joelsa/Jumperless/Hardware/JumperlessRev3.pdf

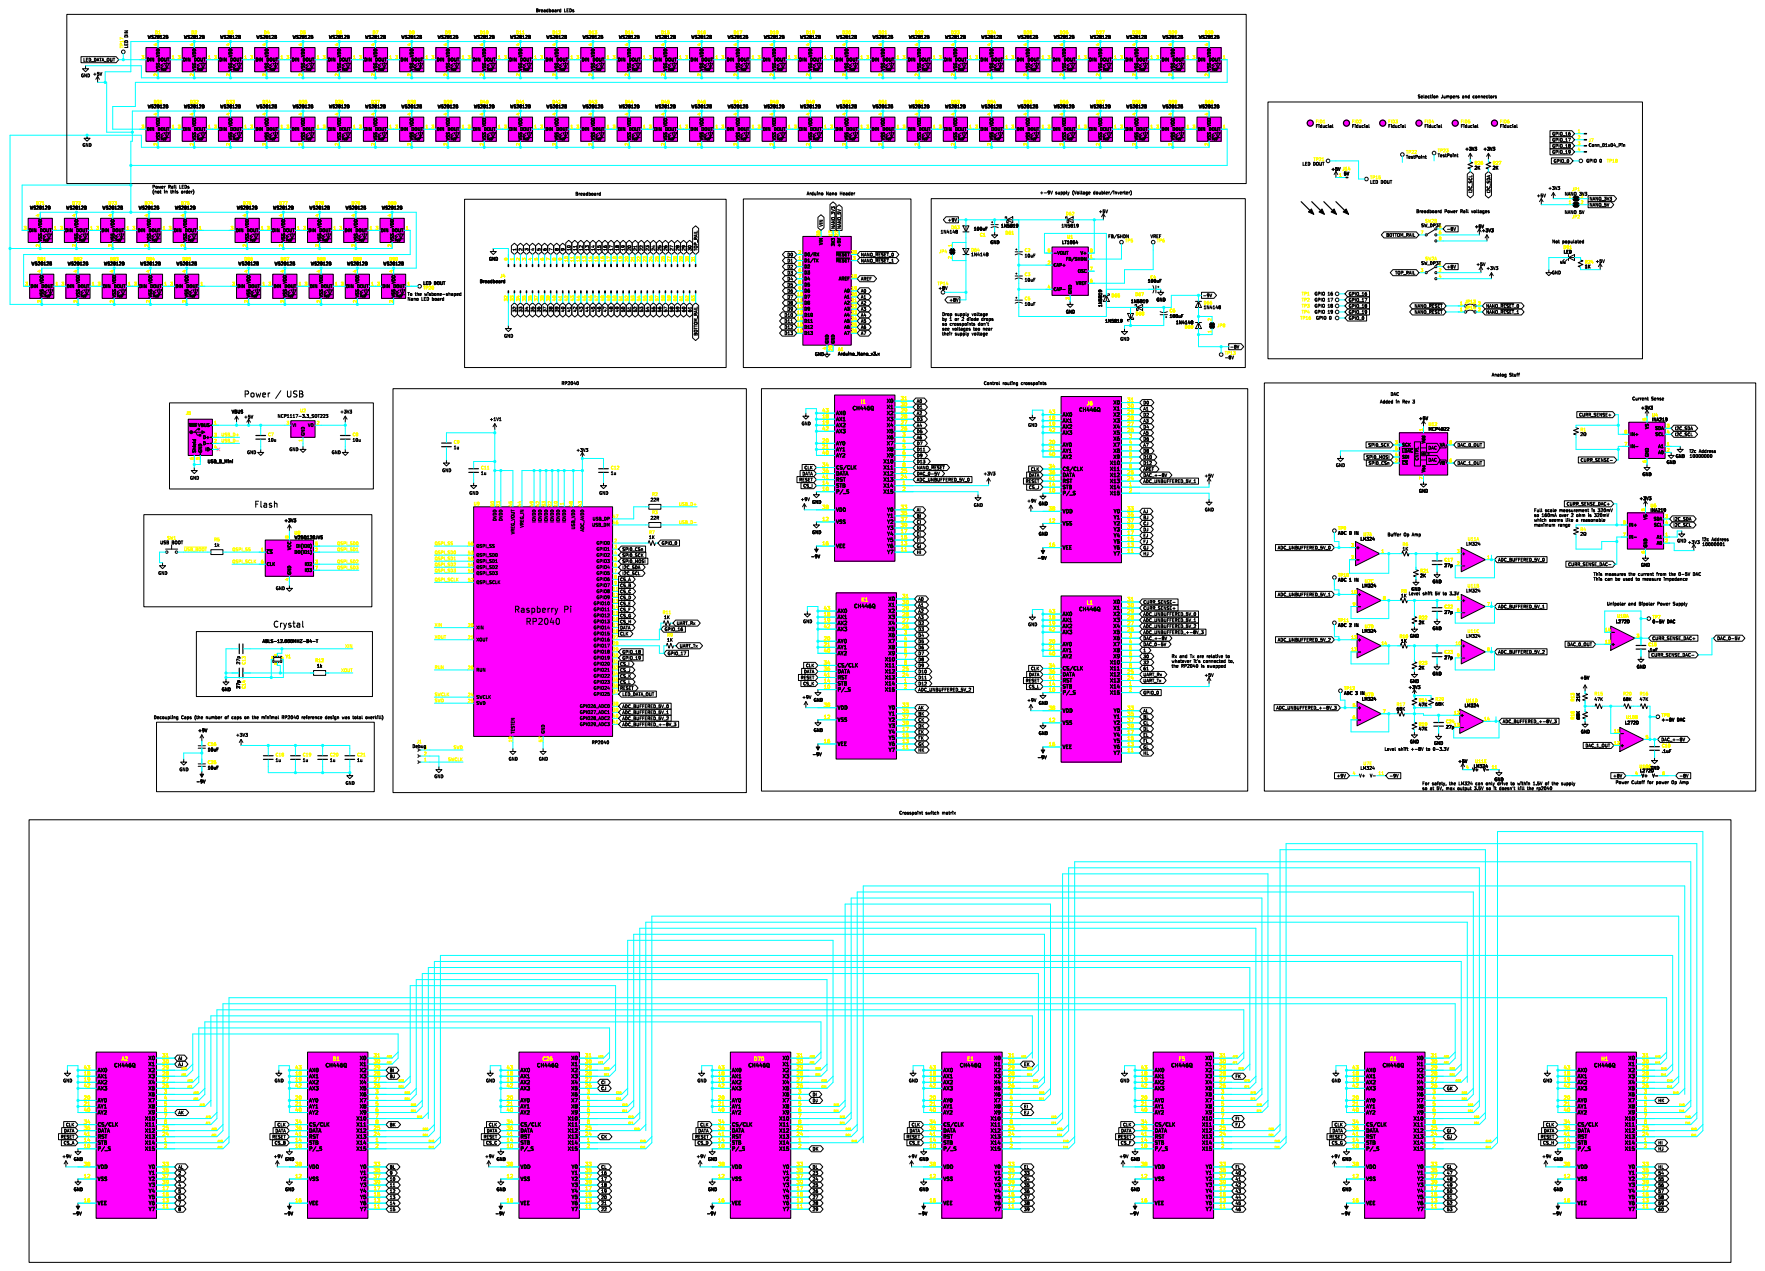
[picture p1: page 1]

To the wisbone-shaped Nano LED board Power Rail LEDs

2 DOUT 1 VBUS D86 WS2812B DIN 3 VDD

Current Sense Drop supply voltage
by 1 or 2 diode drops

their supply voltageControl routing crosspoints

Added in Rev 3 DAC

ADC_UNBUFFERED_5V_1 A7D12 D8 D10 AREF D11 D9 D13 D7A6NANO_~{RESET} HI GI FI AI DI CI BI EI A2D5A4D1 D3

DJ FJHJ GJ EJ BJ CJ AJ

This can be used to measure impedance

For safety, the LM324 can only drive to within 1.5V of the supply
