joelsa/Jumperless/Hardware/KiCAD/Jumperless Rev 3/JumperlessRev3.kicad_sch

## KiCad design Hardware/KiCAD/Jumperless Rev 3/JumperlessRev3.kicad_sch (2026-06-02)

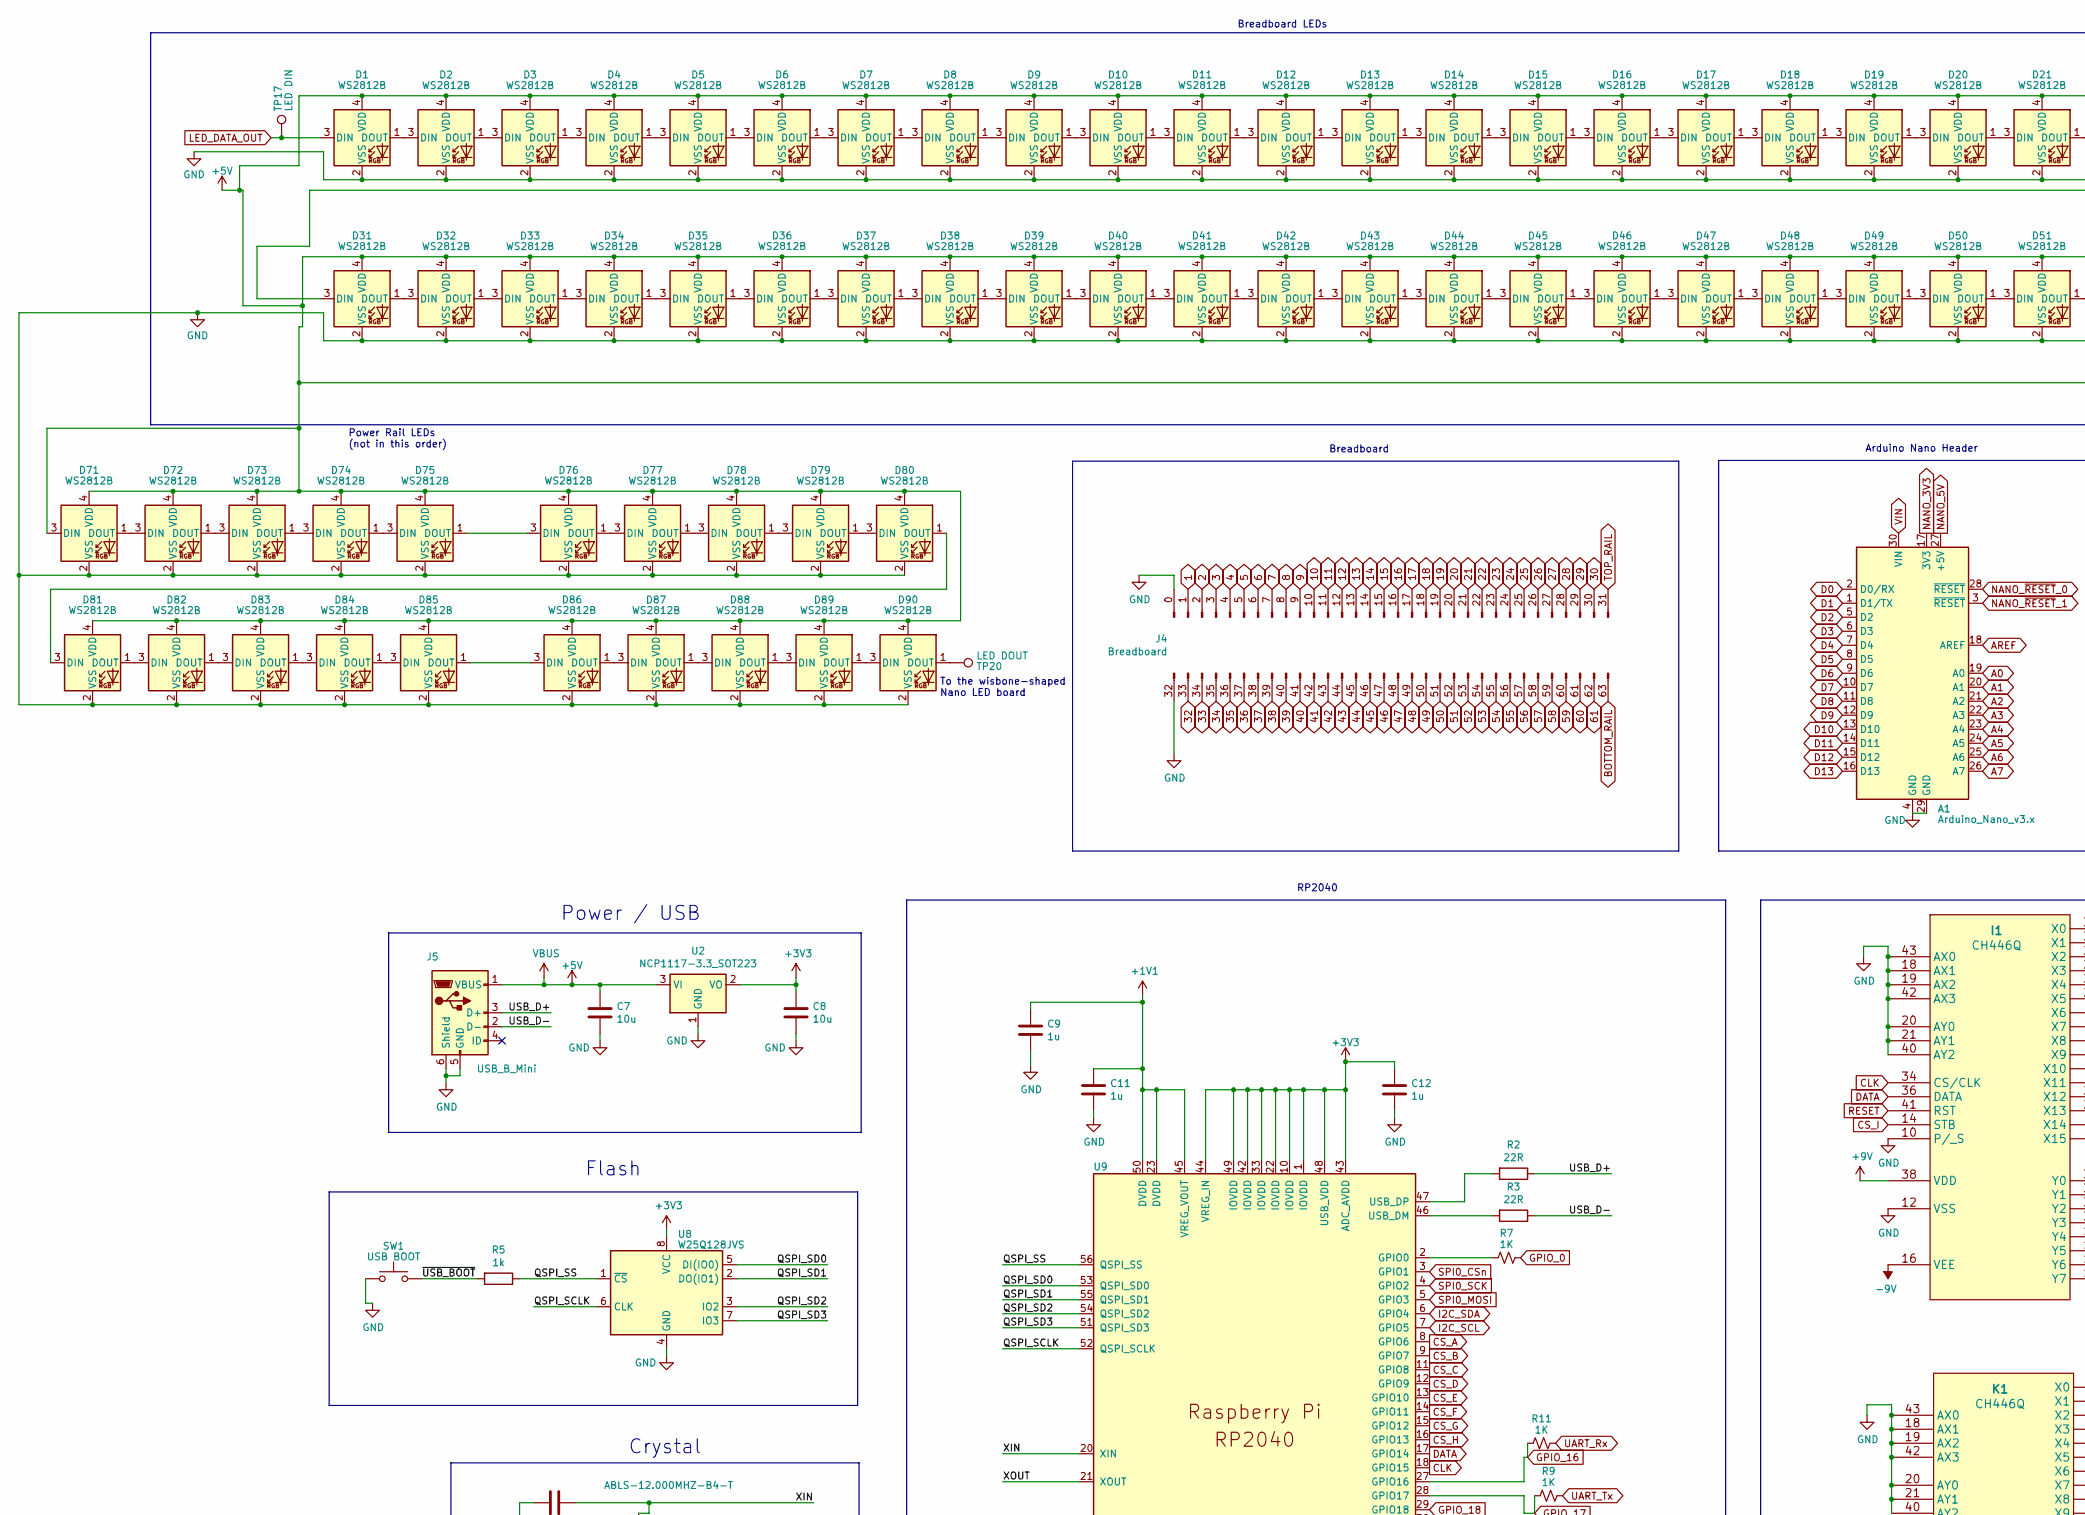
[picture p2: schematic JumperlessRev3.kicad_sch, part in row 1, column 1]

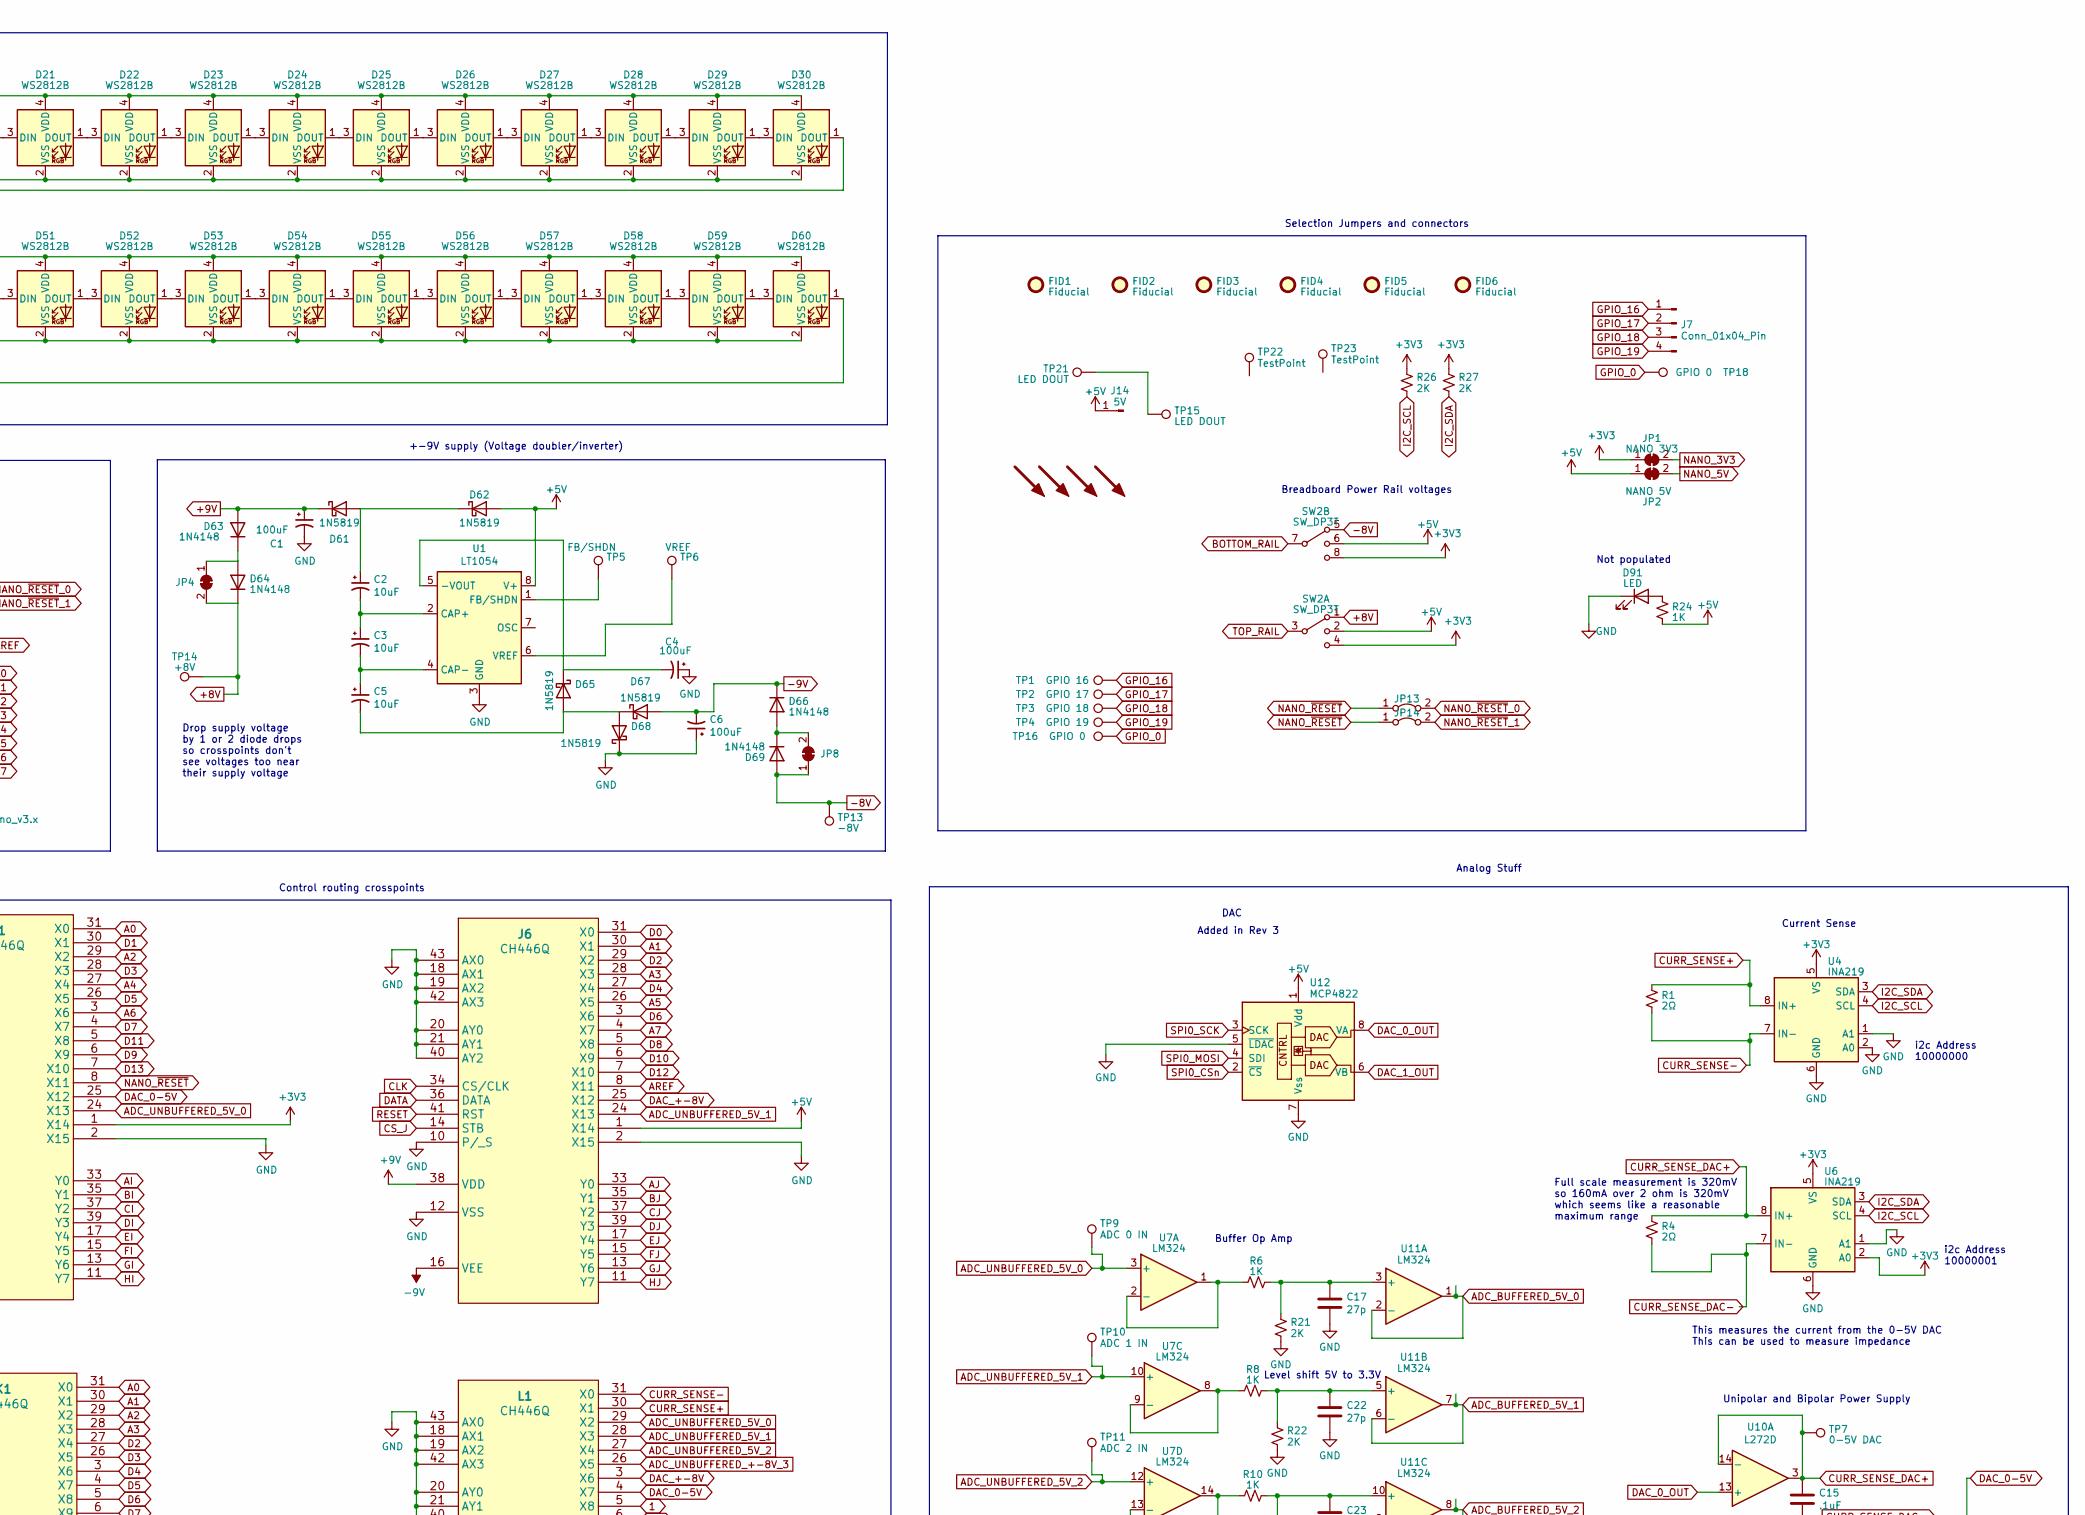
[picture p3: schematic JumperlessRev3.kicad_sch, part in row 1, column 2]

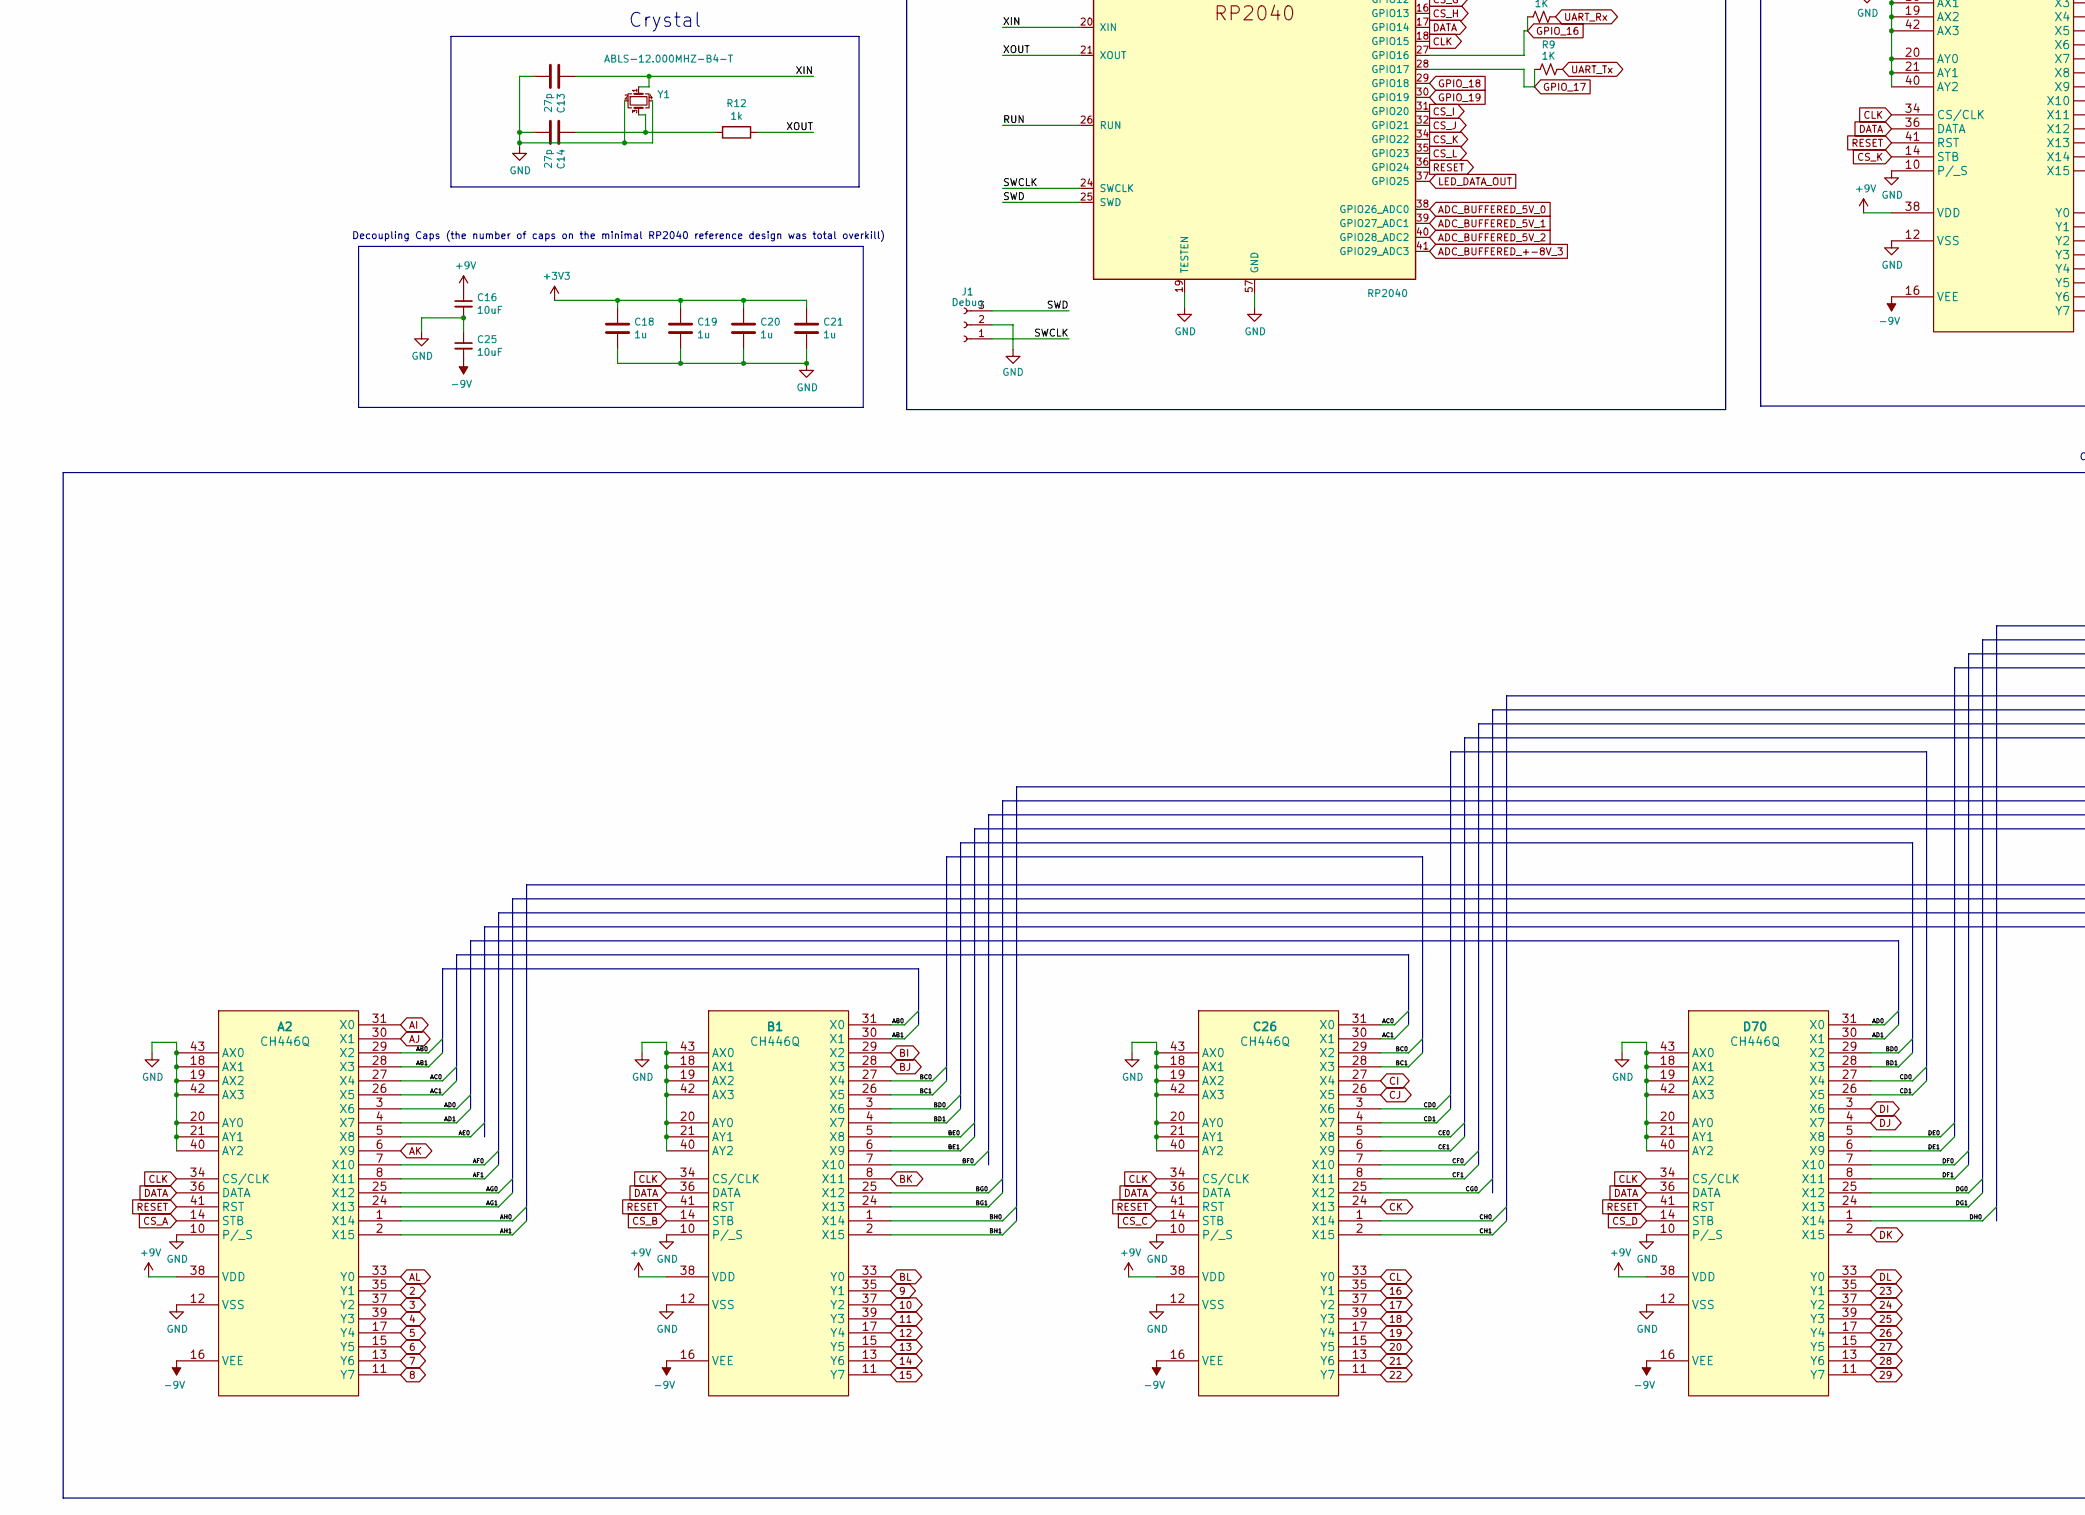
[picture p4: schematic JumperlessRev3.kicad_sch, part in row 2, column 1]

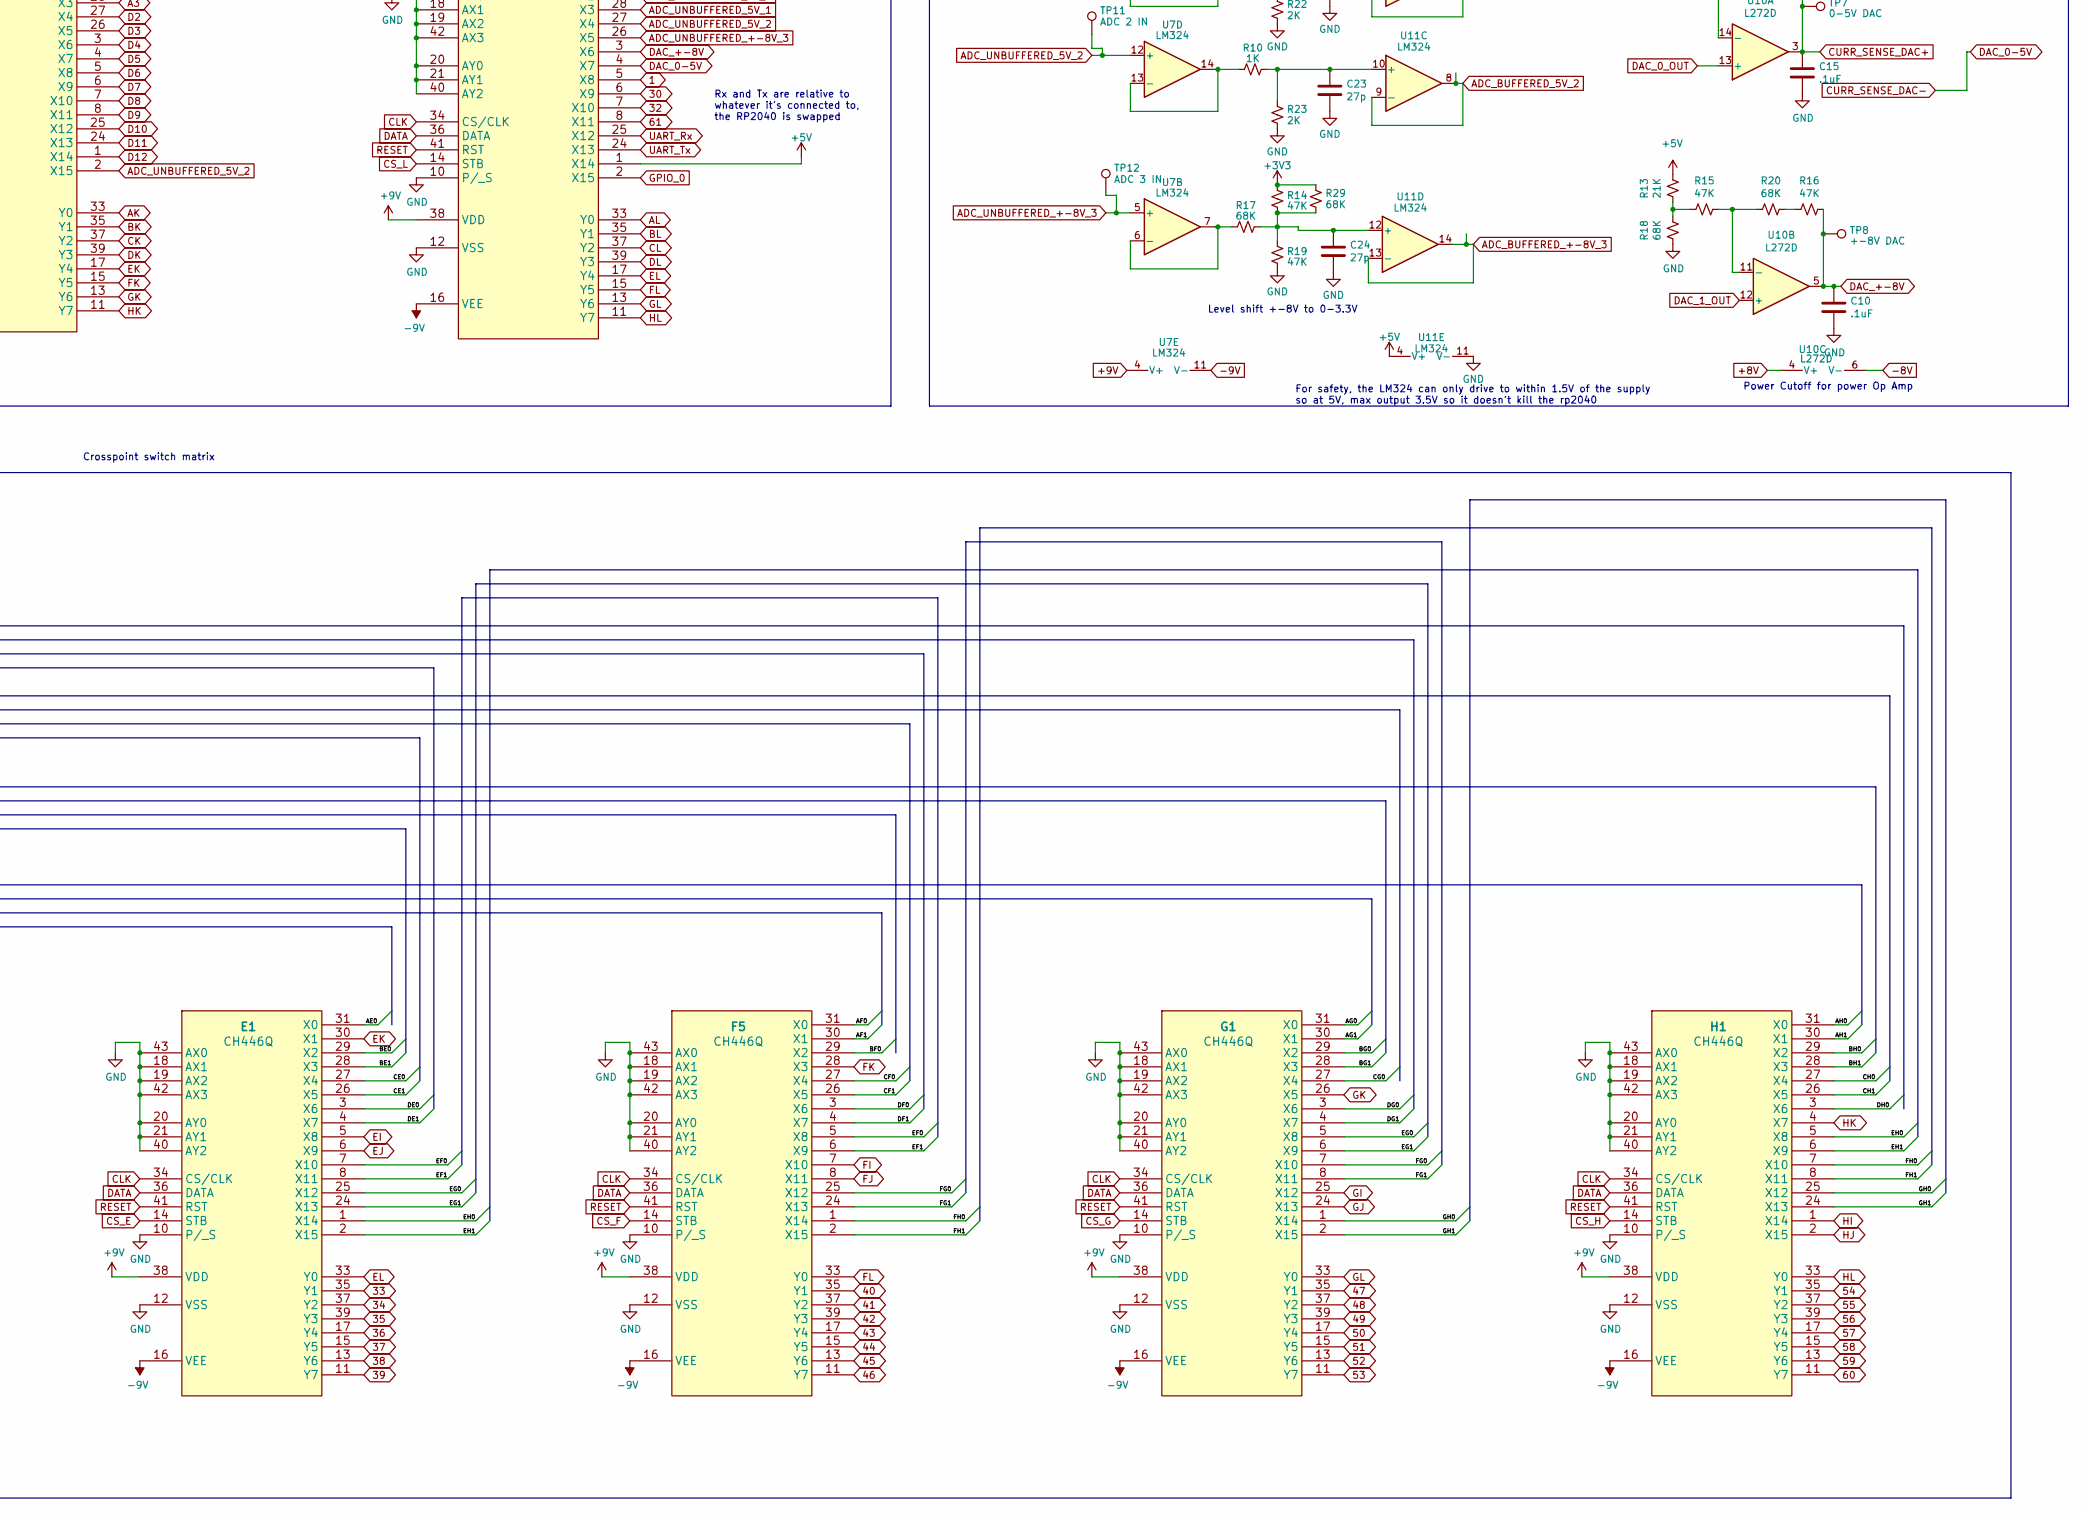
[picture p5: schematic JumperlessRev3.kicad_sch, part in row 2, column 2]

Parts:
A1: Arduino_Nano_v3.x; Arduino_Nano
A2: CH446Q; LQFP44_Tight
B1: CH446Q; LQFP44_Tight
C1, C4, C6: 100uF; C_1206_3216Metric_Pad1.33x1.80mm_HandSolder
C2, C3, C5: 10uF; CP_EIA-6032-20_AVX-F_Pad2.25x2.35mm_HandSolder
C7, C8: 10u; C_0603_1608Metric
C9, C11, C12, C18, C19, C20, C21: 1u; C_0402_1005Metric
C10, C15: .1uF; C_0402_1005Metric
C13, C14, C17, C22, C23, C24: 27p; C_0402_1005Metric
C16, C25: 10uF; C_0603_1608Metric
C26: CH446Q; LQFP44_Tight
D1, D2, D3, D4, D5, D6, D7, D8, D9, D10, D11, D12, D13, D14, D15, D16, D17, D18, D19, D20, D21, D22, D23, D24, D25, D26, D27, D28, D29, D30, D31, D32, D33, D34, D35, D36, D37, D38, D39, D40, D41, D42, D43, D44, D45, D46, D47, D48, D49, D50, D51, D52, D53, D54, D55, D56, D57, D58, D59, D60, D71, D72, D73, D74, D75, D76, D77, D78, D79, D80, D81, D82, D83, D84, D85, D86, D87, D88, D89, D90: WS2812B; LED_WS2812B-2020_PLCC4_2.0x2.0mm
D61, D62, D65, D67, D68: 1N5819; D_SOD-323
D63, D64, D66, D69: 1N4148; D_SOD-323
D70: CH446Q; LQFP44_Tight
D91: LED; LED_PLCC2_reversemount
E1: CH446Q; LQFP44_Tight
F5: CH446Q; LQFP44_Tight
FID1, FID2, FID3, FID4, FID5, FID6: Fiducial; Fiducial_1mm_Mask2mm
G1: CH446Q; LQFP44_Tight
H1: CH446Q; LQFP44_Tight
I1: CH446Q; LQFP44_Tight
J1: Debug; PinHeader_1x03_P2.54mm_Vertical
J4: Breadboard; Breadboard_CustomClips_Fallback
J5: USB_B_Mini; USB_Mini-B_Wuerth_65100516121_Horizontal
J6: CH446Q; LQFP44_Tight
J7: Conn_01x04_Pin; GPIO_header
J14: 5V; PINHEADER-1x1_vertical
JP1: NANO 3V3; SolderJumper_2_Bridged_Small
JP2: NANO 5V; SolderJumper_2_Bridged_Small
JP4, JP8: SolderJumper_2_Bridged; SolderJumper_2_Bridged_Small
JP13, JP14: Jumper_2_Bridged; SolderJumper_2_Bridged_Small
K1: CH446Q; LQFP44_Tight
L1: CH446Q; LQFP44_Tight
R1, R4: 2Ω; R_0603_1608Metric
R2, R3: 22R; R_0402_1005Metric
R5, R12: 1k; R_0402_1005Metric
R6, R7, R8, R9, R10, R11, R24: 1K; R_0402_1005Metric
R13: 21K; R_0402_1005Metric
R14, R15, R16, R19: 47K; R_0402_1005Metric
R17, R18, R20, R29: 68K; R_0402_1005Metric
R21, R22, R23, R26, R27: 2K; R_0402_1005Metric
SW1: USB BOOT; SW_SPST_TL3342
SW2: SW_DP3T; Slide_Switch_SSSS223600
TP1: GPIO 16; TestPoint_Pad_D1.0mm
TP2: GPIO 17; TestPoint_Pad_D1.0mm
TP3: GPIO 18; TestPoint_Pad_D1.0mm
TP4: GPIO 19; TestPoint_Pad_D1.0mm
TP5: FB/SHDN; TestPoint_D0.75mm
TP6: VREF; TestPoint_D0.75mm
TP7: 0-5V DAC; TestPoint_D0.75mm
TP8: +-8V DAC; TestPoint_D0.75mm
TP9: ADC 0 IN; TestPoint_D0.75mm
TP10: ADC 1 IN; TestPoint_D0.75mm
TP11: ADC 2 IN; TestPoint_D0.75mm
TP12: ADC 3 IN; TestPoint_D0.75mm
TP13: -8V; TestPoint_D0.75mm
TP14: +8V; TestPoint_D0.75mm
TP15: LED DOUT; TestPoint_Pad_D1.0mm
TP16: GPIO 0; TestPoint_Pad_D1.0mm
TP17: LED DIN; TestPoint_Pad_D1.0mm
TP18: GPIO 0; PINHEADER-1x1_vertical
TP20, TP21: LED DOUT; PINHEADER-1x1_vertical
TP22, TP23: TestPoint; BackMaskWindows
U1: LT1054; DIP-8_W7.62mm
U2: NCP1117-3.3_SOT223; SOT-223-3_TabPin2
U4, U6: INA219; SOIC-8_3.9x4.9mm_P1.27mm
U7, U11: LM324; SOIC-14_3.9x8.7mm_P1.27mm
U8: W25Q128JVS; SOIC-8_5.23x5.23mm_P1.27mm
U9: RP2040; RP2040-QFN-56
U10: L272D; SOIC-16_3.9x9.9mm_P1.27mm
U12: MCP4822; SOIC-8_3.9x4.9mm_P1.27mm
Y1: ABLS-12.000MHZ-B4-T; Crystal_SMD_3225-4Pin_3.2x2.5mm

Connections:
1: J4.1, L1.5 (X8)
2: A2.35 (Y1), J4.2
3: A2.37 (Y2), J4.3
4: A2.39 (Y3), J4.4
5: A2.17 (Y4), J4.5
6: A2.15 (Y5), J4.6
7: A2.13 (Y6), J4.7
8: A2.11 (Y7), J4.8
9: B1.35 (Y1), J4.9
10: B1.37 (Y2), J4.10
11: B1.39 (Y3), J4.11
12: B1.17 (Y4), J4.12
13: B1.15 (Y5), J4.13
14: B1.13 (Y6), J4.14
15: B1.11 (Y7), J4.15
16: C26.35 (Y1), J4.16
17: C26.37 (Y2), J4.17
18: C26.39 (Y3), J4.18
19: C26.17 (Y4), J4.19
20: C26.15 (Y5), J4.20
21: C26.13 (Y6), J4.21
22: C26.11 (Y7), J4.22
23: D70.35 (Y1), J4.23
24: D70.37 (Y2), J4.24
25: D70.39 (Y3), J4.25
26: D70.17 (Y4), J4.26
27: D70.15 (Y5), J4.27
28: D70.13 (Y6), J4.28
29: D70.11 (Y7), J4.29
30: J4.30, L1.6 (X9)
32: J4.33 (Pin_1), L1.7 (X10)
33: E1.35 (Y1), J4.34 (Pin_2)
34: E1.37 (Y2), J4.35 (Pin_3)
35: E1.39 (Y3), J4.36 (Pin_4)
36: E1.17 (Y4), J4.37 (Pin_5)
37: E1.15 (Y5), J4.38 (Pin_6)
38: E1.13 (Y6), J4.39 (Pin_7)
39: E1.11 (Y7), J4.40 (Pin_8)
40: F5.35 (Y1), J4.41 (Pin_9)
41: F5.37 (Y2), J4.42 (Pin_10)
42: F5.39 (Y3), J4.43 (Pin_11)
43: F5.17 (Y4), J4.44 (Pin_12)
44: F5.15 (Y5), J4.45 (Pin_13)
45: F5.13 (Y6), J4.46 (Pin_14)
46: F5.11 (Y7), J4.47 (Pin_15)
47: G1.35 (Y1), J4.48 (Pin_16)
48: G1.37 (Y2), J4.49 (Pin_17)
49: G1.39 (Y3), J4.50 (Pin_18)
50: G1.17 (Y4), J4.51 (Pin_19)
51: G1.15 (Y5), J4.52 (Pin_20)
52: G1.13 (Y6), J4.53 (Pin_21)
53: G1.11 (Y7), J4.54 (Pin_22)
54: H1.35 (Y1), J4.55 (Pin_23)
55: H1.37 (Y2), J4.56 (Pin_24)
56: H1.39 (Y3), J4.57 (Pin_25)
57: H1.17 (Y4), J4.58 (Pin_26)
58: H1.15 (Y5), J4.59 (Pin_27)
59: H1.13 (Y6), J4.60 (Pin_28)
60: H1.11 (Y7), J4.61 (Pin_29)
61: J4.62 (Pin_30), L1.8 (X11)
+1V1: C9.1, C11.1, U9.23 (DVDD), U9.45 (VREG_VOUT), U9.50 (DVDD)
+3V3: C8.1, C12.1, C18.1, C19.1, C20.1, C21.1, I1.1 (X14), JP1.1 (A), R14.1, R26.1, R27.1, R29.1, SW2.4, SW2.8, U2.2 (VO), U4.5 (VS), U6.2 (A0), U6.5 (VS), U8.8 (VCC), U9.1 (IOVDD), U9.10 (IOVDD), U9.22 (IOVDD), U9.33 (IOVDD), U9.42 (IOVDD), U9.43 (ADC_AVDD), U9.44 (VREG_IN), U9.48 (USB_VDD), U9.49 (IOVDD)
+5V: C7.1, D1.4 (VDD), D2.4 (VDD), D3.4 (VDD), D4.4 (VDD), D5.4 (VDD), D6.4 (VDD), D7.4 (VDD), D8.4 (VDD), D9.4 (VDD), D10.4 (VDD), D11.4 (VDD), D12.4 (VDD), D13.4 (VDD), D14.4 (VDD), D15.4 (VDD), D16.4 (VDD), D17.4 (VDD), D18.4 (VDD), D19.4 (VDD), D20.4 (VDD), D21.4 (VDD), D22.4 (VDD), D23.4 (VDD), D24.4 (VDD), D25.4 (VDD), D26.4 (VDD), D27.4 (VDD), D28.4 (VDD), D29.4 (VDD), D30.4 (VDD), D31.4 (VDD), D32.4 (VDD), D33.4 (VDD), D34.4 (VDD), D35.4 (VDD), D36.4 (VDD), D37.4 (VDD), D38.4 (VDD), D39.4 (VDD), D40.4 (VDD), D41.4 (VDD), D42.4 (VDD), D43.4 (VDD), D44.4 (VDD), D45.4 (VDD), D46.4 (VDD), D47.4 (VDD), D48.4 (VDD), D49.4 (VDD), D50.4 (VDD), D51.4 (VDD), D52.4 (VDD), D53.4 (VDD), D54.4 (VDD), D55.4 (VDD), D56.4 (VDD), D57.4 (VDD), D58.4 (VDD), D59.4 (VDD), D60.1 (DOUT), D60.4 (VDD), D62.2 (A), D71.3 (DIN), D71.4 (VDD), D72.4 (VDD), D73.4 (VDD), D74.4 (VDD), D75.4 (VDD), D76.4 (VDD), D77.4 (VDD), D78.4 (VDD), D79.4 (VDD), D80.4 (VDD), D81.4 (VDD), D82.4 (VDD), D83.4 (VDD), D84.4 (VDD), D85.4 (VDD), D86.4 (VDD), D87.4 (VDD), D88.4 (VDD), D89.4 (VDD), D90.4 (VDD), J5.1 (VBUS), J6.1 (X14), J14.1, JP2.1 (A), L1.1 (X14), R13.2, R24.2, SW2.2, SW2.6, U1.8 (V+), U2.3 (VI), U11.4 (V+), U12.1 (Vdd)
+8V: D64.1 (K), JP4.2 (B), SW2.1, TP14.1, U10.4 (V+)
+9V: A2.38 (VDD), B1.38 (VDD), C1.1, C16.1, C26.38 (VDD), D61.1 (K), D63.2 (A), D70.38 (VDD), E1.38 (VDD), F5.38 (VDD), G1.38 (VDD), H1.38 (VDD), I1.38 (VDD), J6.38 (VDD), K1.38 (VDD), L1.38 (VDD), U7.4 (V+)
-8V: D69.2 (A), JP8.1 (A), SW2.5, TP13.1, U10.6 (V-)
-9V: A2.16 (VEE), B1.16 (VEE), C6.2, C25.2, C26.16 (VEE), D66.1 (K), D67.2 (A), D70.16 (VEE), E1.16 (VEE), F5.16 (VEE), G1.16 (VEE), H1.16 (VEE), I1.16 (VEE), J6.16 (VEE), K1.16 (VEE), L1.16 (VEE), U7.11 (V-)
A0: A1.19 (A0), I1.31 (X0), K1.31 (X0)
A1: A1.20 (A1), J6.30 (X1), K1.30 (X1)
A2: A1.21 (A2), I1.29 (X2), K1.29 (X2)
A3: A1.22 (A3), J6.28 (X3), K1.28 (X3)
A4: A1.23 (A4), I1.27 (X4)
A5: A1.24 (A5), J6.26 (X5)
A6: A1.25 (A6), I1.3 (X6)
A7: A1.26 (A7), J6.4 (X7)
AB0: A2.29 (X2), B1.31 (X0)
AB1: A2.28 (X3), B1.30 (X1)
AC0: A2.27 (X4), C26.31 (X0)
AC1: A2.26 (X5), C26.30 (X1)
AD0: A2.3 (X6), D70.31 (X0)
AD1: A2.4 (X7), D70.30 (X1)
ADC_BUFFERED_5V_0: U9.38 (GPIO26_ADC0), U11.1, U11.2 (-)
ADC_BUFFERED_5V_1: U9.39 (GPIO27_ADC1), U11.6 (-), U11.7
ADC_BUFFERED_5V_2: U9.40 (GPIO28_ADC2), U11.8, U11.9 (-)
ADC_BUFFERED_+-8V_3: U9.41 (GPIO29_ADC3), U11.13 (-), U11.14
ADC_UNBUFFERED_5V_0: I1.24 (X13), L1.29 (X2), TP9.1, U7.3 (+)
ADC_UNBUFFERED_5V_1: J6.24 (X13), L1.28 (X3), TP10.1, U7.10 (+)
ADC_UNBUFFERED_5V_2: K1.2 (X15), L1.27 (X4), TP11.1, U7.12 (+)
ADC_UNBUFFERED_+-8V_3: L1.26 (X5), TP12.1, U7.5 (+)
AE0: A2.5 (X8), E1.31 (X0)
AF0: A2.7 (X10), F5.31 (X0)
AF1: A2.8 (X11), F5.30 (X1)
AG0: A2.25 (X12), G1.31 (X0)
AG1: A2.24 (X13), G1.30 (X1)
AH0: A2.1 (X14), H1.31 (X0)
AH1: A2.2 (X15), H1.30 (X1)
AI: A2.31 (X0), I1.33 (Y0)
AJ: A2.30 (X1), J6.33 (Y0)
AK: A2.6 (X9), K1.33 (Y0)
AL: A2.33 (Y0), L1.33 (Y0)
AREF: A1.18 (AREF), J6.8 (X11)
BC0: B1.27 (X4), C26.29 (X2)
BC1: B1.26 (X5), C26.28 (X3)
BD0: B1.3 (X6), D70.29 (X2)
BD1: B1.4 (X7), D70.28 (X3)
BE0: B1.5 (X8), E1.29 (X2)
BE1: B1.6 (X9), E1.28 (X3)
BF0: B1.7 (X10), F5.29 (X2)
BG0: B1.25 (X12), G1.29 (X2)
BG1: B1.24 (X13), G1.28 (X3)
BH0: B1.1 (X14), H1.29 (X2)
BH1: B1.2 (X15), H1.28 (X3)
BI: B1.29 (X2), I1.35 (Y1)
BJ: B1.28 (X3), J6.35 (Y1)
BK: B1.8 (X11), K1.35 (Y1)
BL: B1.33 (Y0), L1.35 (Y1)
BOTTOM_RAIL: J4.63 (Pin_31), SW2.7
CD0: C26.3 (X6), D70.27 (X4)
CD1: C26.4 (X7), D70.26 (X5)
CE0: C26.5 (X8), E1.27 (X4)
CE1: C26.6 (X9), E1.26 (X5)
CF0: C26.7 (X10), F5.27 (X4)
CF1: C26.8 (X11), F5.26 (X5)
CG0: C26.25 (X12), G1.27 (X4)
CH0: C26.1 (X14), H1.27 (X4)
CH1: C26.2 (X15), H1.26 (X5)
CI: C26.27 (X4), I1.37 (Y2)
CJ: C26.26 (X5), J6.37 (Y2)
CK: C26.24 (X13), K1.37 (Y2)
CL: C26.33 (Y0), L1.37 (Y2)
CLK: A2.34 (CS/CLK), B1.34 (CS/CLK), C26.34 (CS/CLK), D70.34 (CS/CLK), E1.34 (CS/CLK), F5.34 (CS/CLK), G1.34 (CS/CLK), H1.34 (CS/CLK), I1.34 (CS/CLK), J6.34 (CS/CLK), K1.34 (CS/CLK), L1.34 (CS/CLK), U9.18 (GPIO15)
CS_A: A2.14 (STB), U9.8 (GPIO6)
CS_B: B1.14 (STB), U9.9 (GPIO7)
CS_C: C26.14 (STB), U9.11 (GPIO8)
CS_D: D70.14 (STB), U9.12 (GPIO9)
CS_E: E1.14 (STB), U9.13 (GPIO10)
CS_F: F5.14 (STB), U9.14 (GPIO11)
CS_G: G1.14 (STB), U9.15 (GPIO12)
CS_H: H1.14 (STB), U9.16 (GPIO13)
CS_I: I1.14 (STB), U9.31 (GPIO20)
CS_J: J6.14 (STB), U9.32 (GPIO21)
CS_K: K1.14 (STB), U9.34 (GPIO22)
CS_L: L1.14 (STB), U9.35 (GPIO23)
CURR_SENSE+: L1.30 (X1), R1.1, U4.8 (IN+)
CURR_SENSE-: L1.31 (X0), R1.2, U4.7 (IN-)
CURR_SENSE_DAC+: C15.1, R4.1, TP7.1, U6.8 (IN+), U10.3, U10.14 (-)
CURR_SENSE_DAC-: I1.25 (X12), L1.4 (X7), R4.2, U6.7 (IN-)
D0: A1.2 (D0/RX), J6.31 (X0)
D1: A1.1 (D1/TX), I1.30 (X1)
D2: A1.5 (D2), J6.29 (X2), K1.27 (X4)
D3: A1.6 (D3), I1.28 (X3), K1.26 (X5)
D4: A1.7 (D4), J6.27 (X4), K1.3 (X6)
D5: A1.8 (D5), I1.26 (X5), K1.4 (X7)
D6: A1.9 (D6), J6.3 (X6), K1.5 (X8)
D7: A1.10 (D7), I1.4 (X7), K1.6 (X9)
D8: A1.11 (D8), J6.5 (X8), K1.7 (X10)
D9: A1.12 (D9), I1.6 (X9), K1.8 (X11)
D10: A1.13 (D10), J6.6 (X9), K1.25 (X12)
D11: A1.14 (D11), I1.5 (X8), K1.24 (X13)
D12: A1.15 (D12), J6.7 (X10), K1.1 (X14)
D13: A1.16 (D13), I1.7 (X10)
DAC_0_OUT: U10.13 (+), U12.8 (VA)
DAC_1_OUT: U10.12 (+), U12.6 (VB)
DAC_+-8V: C10.1, J6.25 (X12), L1.3 (X6), R16.2, TP8.1, U10.5
DATA: A2.36 (DATA), B1.36 (DATA), C26.36 (DATA), D70.36 (DATA), E1.36 (DATA), F5.36 (DATA), G1.36 (DATA), H1.36 (DATA), I1.36 (DATA), J6.36 (DATA), K1.36 (DATA), L1.36 (DATA), U9.17 (GPIO14)
DE0: D70.5 (X8), E1.3 (X6)
DE1: D70.6 (X9), E1.4 (X7)
DF0: D70.7 (X10), F5.3 (X6)
DF1: D70.8 (X11), F5.4 (X7)
DG0: D70.25 (X12), G1.3 (X6)
DG1: D70.24 (X13), G1.4 (X7)
DH0: D70.1 (X14), H1.3 (X6)
DI: D70.3 (X6), I1.39 (Y3)
DJ: D70.4 (X7), J6.39 (Y3)
DK: D70.2 (X15), K1.39 (Y3)
DL: D70.33 (Y0), L1.39 (Y3)
EF0: E1.7 (X10), F5.5 (X8)
EF1: E1.8 (X11), F5.6 (X9)
EG0: E1.25 (X12), G1.5 (X8)
EG1: E1.24 (X13), G1.6 (X9)
EH0: E1.1 (X14), H1.5 (X8)
EH1: E1.2 (X15), H1.6 (X9)
EI: E1.5 (X8), I1.17 (Y4)
EJ: E1.6 (X9), J6.17 (Y4)
EK: E1.30 (X1), K1.17 (Y4)
EL: E1.33 (Y0), L1.17 (Y4)
FG0: F5.25 (X12), G1.7 (X10)
FG1: F5.24 (X13), G1.8 (X11)
FH0: F5.1 (X14), H1.7 (X10)
FH1: F5.2 (X15), H1.8 (X11)
FI: F5.7 (X10), I1.15 (Y5)
FJ: F5.8 (X11), J6.15 (Y5)
FK: F5.28 (X3), K1.15 (Y5)
FL: F5.33 (Y0), L1.15 (Y5)
GH0: G1.1 (X14), H1.25 (X12)
GH1: G1.2 (X15), H1.24 (X13)
GI: G1.25 (X12), I1.13 (Y6)
GJ: G1.24 (X13), J6.13 (Y6)
GK: G1.26 (X5), K1.13 (Y6)
GL: G1.33 (Y0), L1.13 (Y6)
GND: A1.4 (GND), A1.29 (GND), A2.10 (P/_S), A2.12 (VSS), A2.18 (AX1), A2.19 (AX2), A2.20 (AY0), A2.21 (AY1), A2.40 (AY2), A2.42 (AX3), A2.43 (AX0), B1.10 (P/_S), B1.12 (VSS), B1.18 (AX1), B1.19 (AX2), B1.20 (AY0), B1.21 (AY1), B1.40 (AY2), B1.42 (AX3), B1.43 (AX0), C1.2, C4.1, C6.1, C7.2, C8.2, C9.2, C10.2, C11.2, C12.2, C13.2, C14.2, C15.2, C16.2, C17.2, C18.2, C19.2, C20.2, C21.2, C22.2, C23.2, C24.2, C25.1, C26.10 (P/_S), C26.12 (VSS), C26.18 (AX1), C26.19 (AX2), C26.20 (AY0), C26.21 (AY1), C26.40 (AY2), C26.42 (AX3), C26.43 (AX0), D1.2 (VSS), D2.2 (VSS), D3.2 (VSS), D4.2 (VSS), D5.2 (VSS), D6.2 (VSS), D7.2 (VSS), D8.2 (VSS), D9.2 (VSS), D10.2 (VSS), D11.2 (VSS), D12.2 (VSS), D13.2 (VSS), D14.2 (VSS), D15.2 (VSS), D16.2 (VSS), D17.2 (VSS), D18.2 (VSS), D19.2 (VSS), D20.2 (VSS), D21.2 (VSS), D22.2 (VSS), D23.2 (VSS), D24.2 (VSS), D25.2 (VSS), D26.2 (VSS), D27.2 (VSS), D28.2 (VSS), D29.2 (VSS), D30.2 (VSS), D31.2 (VSS), D32.2 (VSS), D33.2 (VSS), D34.2 (VSS), D35.2 (VSS), D36.2 (VSS), D37.2 (VSS), D38.2 (VSS), D39.2 (VSS), D40.2 (VSS), D41.2 (VSS), D42.2 (VSS), D43.2 (VSS), D44.2 (VSS), D45.2 (VSS), D46.2 (VSS), D47.2 (VSS), D48.2 (VSS), D49.2 (VSS), D50.2 (VSS), D51.2 (VSS), D52.2 (VSS), D53.2 (VSS), D54.2 (VSS), D55.2 (VSS), D56.2 (VSS), D57.2 (VSS), D58.2 (VSS), D59.2 (VSS), D60.2 (VSS), D68.1 (K), D70.10 (P/_S), D70.12 (VSS), D70.18 (AX1), D70.19 (AX2), D70.20 (AY0), D70.21 (AY1), D70.40 (AY2), D70.42 (AX3), D70.43 (AX0), D71.2 (VSS), D72.2 (VSS), D73.2 (VSS), D74.2 (VSS), D75.2 (VSS), D76.2 (VSS), D77.2 (VSS), D78.2 (VSS), D79.2 (VSS), D80.2 (VSS), D81.2 (VSS), D82.2 (VSS), D83.2 (VSS), D84.2 (VSS), D85.2 (VSS), D86.2 (VSS), D87.2 (VSS), D88.2 (VSS), D89.2 (VSS), D90.2 (VSS), D91.1 (K), E1.10 (P/_S), E1.12 (VSS), E1.18 (AX1), E1.19 (AX2), E1.20 (AY0), E1.21 (AY1), E1.40 (AY2), E1.42 (AX3), E1.43 (AX0), F5.10 (P/_S), F5.12 (VSS), F5.18 (AX1), F5.19 (AX2), F5.20 (AY0), F5.21 (AY1), F5.40 (AY2), F5.42 (AX3), F5.43 (AX0), G1.10 (P/_S), G1.12 (VSS), G1.18 (AX1), G1.19 (AX2), G1.20 (AY0), G1.21 (AY1), G1.40 (AY2), G1.42 (AX3), G1.43 (AX0), H1.10 (P/_S), H1.12 (VSS), H1.18 (AX1), H1.19 (AX2), H1.20 (AY0), H1.21 (AY1), H1.40 (AY2), H1.42 (AX3), H1.43 (AX0), I1.2 (X15), I1.10 (P/_S), I1.12 (VSS), I1.18 (AX1), I1.19 (AX2), I1.20 (AY0), I1.21 (AY1), I1.40 (AY2), I1.42 (AX3), I1.43 (AX0), J1.2, J4.0, J4.32 (Pin_0), J5.5 (GND), J5.6 (Shield), J6.2 (X15), J6.10 (P/_S), J6.12 (VSS), J6.18 (AX1), J6.19 (AX2), J6.20 (AY0), J6.21 (AY1), J6.40 (AY2), J6.42 (AX3), J6.43 (AX0), K1.10 (P/_S), K1.12 (VSS), K1.18 (AX1), K1.19 (AX2), K1.20 (AY0), K1.21 (AY1), K1.40 (AY2), K1.42 (AX3), K1.43 (AX0), L1.10 (P/_S), L1.12 (VSS), L1.18 (AX1), L1.19 (AX2), L1.20 (AY0), L1.21 (AY1), L1.40 (AY2), L1.42 (AX3), L1.43 (AX0), R18.1, R19.2, R21.2, R22.2, R23.2, SW1.1, U1.3 (GND), U2.1 (GND), U4.1 (A1), U4.2 (A0), U4.6 (GND), U6.1 (A1), U6.6 (GND), U8.4 (GND), U9.19 (TESTEN), U9.57 (GND), U11.11 (V-), U12.5 (~LDAC), U12.7 (Vss), Y1.2, Y1.4
GPIO_0: L1.2 (X15), R7.2, TP16.1, TP18.1
GPIO_16: J7.1, R11.1, TP1.1, U9.27 (GPIO16)
GPIO_17: J7.2, R9.1, TP2.1, U9.28 (GPIO17)
GPIO_18: J7.3, TP3.1, U9.29 (GPIO18)
GPIO_19: J7.4, TP4.1, U9.30 (GPIO19)
HI: H1.1 (X14), I1.11 (Y7)
HJ: H1.2 (X15), J6.11 (Y7)
HK: H1.4 (X7), K1.11 (Y7)
HL: H1.33 (Y0), L1.11 (Y7)
I2C_SCL: R26.2, U4.4 (SCL), U6.4 (SCL), U9.7 (GPIO5)
I2C_SDA: R27.2, U4.3 (SDA), U6.3 (SDA), U9.6 (GPIO4)
LED_DATA_OUT: D1.3 (DIN), TP17.1, U9.37 (GPIO25)
NANO_3V3: A1.17 (3V3), JP1.2 (B)
NANO_5V: A1.27 (+5V), JP2.2 (B)
NANO_~RESET: I1.8 (X11), JP13.1 (A), JP14.1 (A)
NANO_~RESET_0: A1.28 (~RESET), JP13.2 (B)
NANO_~RESET_1: A1.3 (~RESET), JP14.2 (B)
unnamed: C2.1, D61.2 (A), D62.1 (K)
unnamed: C2.2, C3.1, U1.2 (CAP+)
unnamed: C3.2, C5.1, U1.4 (CAP-)
unnamed: C4.2, D65.1 (K), U1.5 (-VOUT)
unnamed: C5.2, D65.2 (A), D67.1 (K), D68.2 (A)
unnamed: C14.1, R12.2, Y1.3
unnamed: C17.1, R6.2, R21.1, U11.3 (+)
unnamed: C22.1, R8.2, R22.1, U11.5 (+)
unnamed: C23.1, R10.2, R23.1, U11.10 (+)
unnamed: C24.1, R14.2, R17.2, R19.1, R29.2, U11.12 (+)
unnamed: D1.1 (DOUT), D2.3 (DIN)
unnamed: D2.1 (DOUT), D3.3 (DIN)
unnamed: D3.1 (DOUT), D4.3 (DIN)
unnamed: D4.1 (DOUT), D5.3 (DIN)
unnamed: D5.1 (DOUT), D6.3 (DIN)
unnamed: D6.1 (DOUT), D7.3 (DIN)
unnamed: D7.1 (DOUT), D8.3 (DIN)
unnamed: D8.1 (DOUT), D9.3 (DIN)
unnamed: D10.1 (DOUT), D11.3 (DIN)
unnamed: D9.1 (DOUT), D10.3 (DIN)
unnamed: D11.1 (DOUT), D12.3 (DIN)
unnamed: D12.1 (DOUT), D13.3 (DIN)
unnamed: D13.1 (DOUT), D14.3 (DIN)
unnamed: D14.1 (DOUT), D15.3 (DIN)
unnamed: D15.1 (DOUT), D16.3 (DIN)
unnamed: D16.1 (DOUT), D17.3 (DIN)
unnamed: D17.1 (DOUT), D18.3 (DIN)
unnamed: D18.1 (DOUT), D19.3 (DIN)
unnamed: D19.1 (DOUT), D20.3 (DIN)
unnamed: D20.1 (DOUT), D21.3 (DIN)
unnamed: D21.1 (DOUT), D22.3 (DIN)
unnamed: D22.1 (DOUT), D23.3 (DIN)
unnamed: D23.1 (DOUT), D24.3 (DIN)
unnamed: D24.1 (DOUT), D25.3 (DIN)
unnamed: D25.1 (DOUT), D26.3 (DIN)
unnamed: D26.1 (DOUT), D27.3 (DIN)
unnamed: D27.1 (DOUT), D28.3 (DIN)
unnamed: D28.1 (DOUT), D29.3 (DIN)
unnamed: D29.1 (DOUT), D30.3 (DIN)
unnamed: D30.1 (DOUT), D31.3 (DIN)
unnamed: D31.1 (DOUT), D32.3 (DIN)
unnamed: D32.1 (DOUT), D33.3 (DIN)
unnamed: D33.1 (DOUT), D34.3 (DIN)
unnamed: D34.1 (DOUT), D35.3 (DIN)
unnamed: D35.1 (DOUT), D36.3 (DIN)
unnamed: D36.1 (DOUT), D37.3 (DIN)
unnamed: D37.1 (DOUT), D38.3 (DIN)
unnamed: D38.1 (DOUT), D39.3 (DIN)
unnamed: D39.1 (DOUT), D40.3 (DIN)
unnamed: D40.1 (DOUT), D41.3 (DIN)
unnamed: D41.1 (DOUT), D42.3 (DIN)
unnamed: D42.1 (DOUT), D43.3 (DIN)
unnamed: D43.1 (DOUT), D44.3 (DIN)
unnamed: D44.1 (DOUT), D45.3 (DIN)
unnamed: D45.1 (DOUT), D46.3 (DIN)
unnamed: D46.1 (DOUT), D47.3 (DIN)
unnamed: D47.1 (DOUT), D48.3 (DIN)
unnamed: D48.1 (DOUT), D49.3 (DIN)
unnamed: D49.1 (DOUT), D50.3 (DIN)
unnamed: D50.1 (DOUT), D51.3 (DIN)
unnamed: D51.1 (DOUT), D52.3 (DIN)
unnamed: D52.1 (DOUT), D53.3 (DIN)
unnamed: D53.1 (DOUT), D54.3 (DIN)
unnamed: D54.1 (DOUT), D55.3 (DIN)
unnamed: D55.1 (DOUT), D56.3 (DIN)
unnamed: D56.1 (DOUT), D57.3 (DIN)
unnamed: D57.1 (DOUT), D58.3 (DIN)
unnamed: D58.1 (DOUT), D59.3 (DIN)
unnamed: D59.1 (DOUT), D60.3 (DIN)
unnamed: D63.1 (K), D64.2 (A), JP4.1 (A)
unnamed: D66.2 (A), D69.1 (K), JP8.2 (B)
unnamed: D71.1 (DOUT), D72.3 (DIN)
unnamed: D72.1 (DOUT), D73.3 (DIN)
unnamed: D73.1 (DOUT), D74.3 (DIN)
unnamed: D74.1 (DOUT), D75.3 (DIN)
unnamed: D75.1 (DOUT), D76.3 (DIN)
unnamed: D76.1 (DOUT), D77.3 (DIN)
unnamed: D77.1 (DOUT), D78.3 (DIN)
unnamed: D78.1 (DOUT), D79.3 (DIN)
unnamed: D79.1 (DOUT), D80.3 (DIN)
unnamed: D80.1 (DOUT), D81.3 (DIN)
unnamed: D81.1 (DOUT), D82.3 (DIN)
unnamed: D82.1 (DOUT), D83.3 (DIN)
unnamed: D83.1 (DOUT), D84.3 (DIN)
unnamed: D84.1 (DOUT), D85.3 (DIN)
unnamed: D85.1 (DOUT), D86.3 (DIN)
unnamed: D86.1 (DOUT), D87.3 (DIN)
unnamed: D87.1 (DOUT), D88.3 (DIN)
unnamed: D88.1 (DOUT), D89.3 (DIN)
unnamed: D89.1 (DOUT), D90.3 (DIN)
unnamed: D90.1 (DOUT), TP20.1
unnamed: D91.2 (A), R24.1
unnamed: R2.2, U9.47 (USB_DP)
unnamed: R3.2, U9.46 (USB_DM)
unnamed: R6.1, U7.1, U7.2 (-)
unnamed: R7.1, U9.2 (GPIO0)
unnamed: R8.1, U7.8, U7.9 (-)
unnamed: R10.1, U7.13 (-), U7.14
unnamed: R13.1, R15.1, R18.2
unnamed: R15.2, R20.1, U10.11 (-)
unnamed: R16.1, R20.2
unnamed: R17.1, U7.6 (-), U7.7
unnamed: TP5.1, U1.1 (FB/SHDN)
unnamed: TP6.1, U1.6 (VREF)
unnamed: TP15.1, TP21.1
QSPI_SCLK: U8.6 (CLK), U9.52 (QSPI_SCLK)
QSPI_SD0: U8.5 (DI(IO0)), U9.53 (QSPI_SD0)
QSPI_SD1: U8.2 (DO(IO1)), U9.55 (QSPI_SD1)
QSPI_SD2: U8.3 (IO2), U9.54 (QSPI_SD2)
QSPI_SD3: U8.7 (IO3), U9.51 (QSPI_SD3)
QSPI_SS: R5.1, U8.1 (~CS), U9.56 (QSPI_SS)
RESET: A2.41 (RST), B1.41 (RST), C26.41 (RST), D70.41 (RST), E1.41 (RST), F5.41 (RST), G1.41 (RST), H1.41 (RST), I1.41 (RST), J6.41 (RST), K1.41 (RST), L1.41 (RST), U9.36 (GPIO24)
RUN: U9.26 (RUN)
SPI0_CSn: U9.3 (GPIO1), U12.2 (~CS)
SPI0_MOSI: U9.5 (GPIO3), U12.4 (SDI)
SPI0_SCK: U9.4 (GPIO2), U12.3 (SCK)
SWCLK: J1.1, U9.24 (SWCLK)
SWD: J1.3, U9.25 (SWD)
TOP_RAIL: J4.31, SW2.3
UART_Rx: L1.25 (X12), R11.2
UART_Tx: L1.24 (X13), R9.2
USB_D+: J5.3 (D+), R2.1
USB_D-: J5.2 (D-), R3.1
VIN: A1.30 (VIN)
XIN: C13.1, U9.20 (XIN), Y1.1
XOUT: R12.1, U9.21 (XOUT)
~USB_BOOT: R5.2, SW1.2

Notes on the sheet:
Current Sense
Unipolar and Bipolar Power Supply
Arduino Nano Header
RP2040
Crosspoint switch matrix
Not populated
i2c Address 10000000
Power Rail LEDs (not in this order)
Breadboard
Flash
+-9V supply (Voltage doubler/inverter)
Control routing crosspoints
This measures the current from the 0-5V DAC This can be used to measure impedance
Crystal
For safety, the LM324 can only drive to within 1.5V of the supply so at 5V, max output 3.5V so it doesn't kill the rp2040
Analog Stuff
Added in Rev 3
Power Cutoff for power Op Amp
Buffer Op Amp
To the wisbone-shaped Nano LED board
Power / USB
Drop supply voltage by 1 or 2 diode drops so crosspoints don't see voltages too near their supply voltage
Level shift 5V to 3.3V
DAC
Rx and Tx are relative to whatever it's connected to, the RP2040 is swapped
i2c Address 10000001
Decoupling Caps (the number of caps on the minimal RP2040 reference design was total overkill)
Level shift +-8V to 0-3.3V
Selection Jumpers and connectors
Breadboard LEDs
Breadboard Power Rail voltages
Full scale measurement is 320mV so 160mA over 2 ohm is 320mV which seems like a reasonable maximum range
