joelsa/Jumperless/JumperlessBackport/src/main.cpp

// SPDX-License-Identifier: MIT

/*
Kevin Santo Cappuccio
Architeuthis Flux

KevinC@ppucc.io

5/28/2024

*/






#include <Arduino.h>
// void setup() {
//   pinMode(LED_BUILTIN, OUTPUT);
//   pinMode(2, OUTPUT);
//   pinMode(3, OUTPUT);
//   pinMode(4, OUTPUT);
//   pinMode(5, OUTPUT);
//   pinMode(6, OUTPUT);
//   pinMode(7, OUTPUT);
//   pinMode(8, OUTPUT);
// }

// void loop() {

//   digitalWrite(LED_BUILTIN, HIGH);

//   for (int i = 8; i <= 2; i--) {
//     digitalWrite(i, HIGH);
//     delay(50);
//     digitalWrite(i, LOW);
//   }

// digitalWrite(LED_BUILTIN, LOW);
// delay (50);
// }




#define USE_TINYUSB 1

#define LED LED_BUILTIN

#ifdef USE_TINYUSB
#include <Adafruit_TinyUSB.h>
#endif

#ifdef CFG_TUSB_CONFIG_FILE
#include CFG_TUSB_CONFIG_FILE
#else
#include "tusb_config.h"
#endif

#include "ArduinoStuff.h"
#include "JumperlessDefinesRP2040.h"
#include "MatrixStateRP2040.h"
#include "NetManager.h"

#include "LEDs.h"
#include "NetsToChipConnections.h"
// #include "CH446Q.h"
#include "MachineCommands.h"
#include "Peripherals.h"
#include <Adafruit_NeoPixel.h>
#include <Wire.h>
// #include <EEPROM.h>

#include <EEPROM.h>

#include "CH446Q.h"
#include "FileParsing.h"
#include "RotaryEncoder.h"

#include "LittleFS.h"

#include "Probing.h"

// #include "AdcUsb.h"

// #include "logic_analyzer.h"
// #include "pico/multicore.h"
// #include "hardware/watchdog.h"

// using namespace logic_analyzer;

// int pinStart=26;
// int numberOfPins=2;
// LogicAnalyzer logicAnalyzer;
// Capture capture(MAX_FREQ, MAX_FREQ_THRESHOLD);
volatile int core1busy = 0;
volatile int core2busy = 0;
volatile int core1request = 0;

volatile int pauseCore1 = 0;
volatile int readingFromArduino = 0;

Adafruit_USBD_CDC USBSer1;

int supplySwitchPosition = 0;

// void machineMode(void);
// void lastNetConfirm(int forceLastNet = 0);


// int machineMode = 0;

volatile int sendAllPathsCore2 =
0; // this signals the core 2 to send all the paths to the CH446Q

int loadFileOnStart = 1;
int rotEncInit = 0;
// https://wokwi.com/projects/367384677537829889

int core2setupFinished = 0;

int baudRate = 115200;

int excelCounter = 0;

void setup() {
  pinMode(0, OUTPUT);
  pinMode(2, INPUT);
  pinMode(3, INPUT);

  // debugFlagInit();
  USBDevice.setProductDescriptor("Jumperless");
  USBDevice.setManufacturerDescriptor("Architeuthis Flux");
  USBDevice.setSerialDescriptor("0");
  USBDevice.setID(0x1D50, 0xACAB);
  USBDevice.addStringDescriptor("Jumperless");
  USBDevice.addStringDescriptor("Architeuthis Flux");

  USBSer1.setStringDescriptor("Jumperless USB Serial");

  USBSer1.begin(115200);

#ifdef EEPROMSTUFF
  EEPROM.begin(256);
  debugFlagInit();

#endif
  // delay(1);
  // initADC();
  delay(1);
  initDAC(); // also sets revisionNumber
  delay(1);
  initINA219();
  delay(1);
  Serial.begin(115200);

  initArduino();
  delay(4);

  LittleFS.begin();

  setDac0_5Vvoltage(0.0);
  setDac1_8Vvoltage(1.9);

  // if (rotaryEncoderMode == 1)
  // {
  createSlots(-1, rotaryEncoderMode);
  //}
  //
  clearAllNTCC();

  // if (rotaryEncoderMode == 1)
  // {
  // rotEncInit = 1;
  // initRotaryEncoder();
  //}
  initADC();
  pinMode(0, OUTPUT);
  digitalWrite(0, LOW);
  // delay(20);
  // setupAdcUsbStuff(); // I took this out because it was causing a crash on
  delay(10);
  setBaudRate(baudRate);
  }

void setup1() {
  delay(4);

  initCH446Q();

  delay(4);
  initLEDs();
  delay(4);
  startupColors();
  delay(4);
  lightUpRail();
  core2setupFinished = 1;
  delay(4);

  showLEDsCore2 = 1;
  }

char connectFromArduino = '\0';

char input;

int serSource = 0;
int readInNodesArduino = 0;


volatile char arduinoCommand = '\0';


const char firmwareVersion[] = "1.3.23"; //// remember to update this

int firstLoop = 1;
volatile int probeActive = 1;

int showExtraMenu = 0;
int printingMeasurements = 0;

int arduinoReset = 0;

unsigned long lastButtonCheck = 0;
unsigned long buttonCheckInterval = 300;


void loop() {

  unsigned long timer = 0;

menu:

  // showMeasurements();
  //   unsigned long connecttimer = 0;
  // //   while (tud_connected() == 0)
  // //   {
  // // connecttimer = millis();

  // //   }
  // Serial.print("Updated!\n\r");

  Serial.print("\n\n\r\t\tMenu\n\r");
  // Serial.print("Slot ");
  // Serial.print(netSlot);
  Serial.print("\n\r");
  Serial.print("\tm = show this menu\n\r");
  Serial.print("\tn = show netlist\n\r");
  Serial.print("\ts = show node files by slot\n\r");
  Serial.print("\tb = show bridge array\n\r");
  Serial.print("\tf = load node file to current slot\n\r");
  Serial.print("\tr = rotary encoder mode -");
  rotaryEncoderMode == 1 ? Serial.print(" ON (z/x to cycle)\n\r")
    : Serial.print(" off\n\r");
  Serial.print("\t\b\bz/x = cycle slots - current slot ");


  Serial.print(netSlot);

  Serial.print("\n\r");
  Serial.print("\t\b\bq/Q = set GPIO 0 low/HIGH\n\r");
  Serial.print("\t\b\ba/A = dis/connect UART to Nano\n\r");
  Serial.print("\te = show extra menu options\n\r");

  if (showExtraMenu == 1) {

    Serial.print("\n\r\to = load node files by slot\n\r");
    Serial.print("\th = send raw XY paths\n\r");
    Serial.print("\tp = probe connections\n\r");
    Serial.print("\tw = waveGen\n\r");
    Serial.print("\tv = toggle show current/voltage\n\r");
    Serial.print("\tu = set baud rate for USB-Serial\n\r");
    Serial.print("\tj = just read probe row\n\r");
    Serial.print("\tl = LED brightness / test\n\r");
    Serial.print("\td = toggle debug flags\n\r");
    }
  // Serial.print("\tc = clear nodes with probe\n\r");
  Serial.print("\n\n\r");

  // Serial.print("\n\n\r\t\tMenu\n\r");
  // Serial.print("\t-------------------------\n\r");
  // Serial.print("\tBasic Commands:\n\r");
  // Serial.print("\tm - Show this menu\n\r");
  // Serial.print("\tn - Show netlist\n\r");
  // Serial.print("\tz/x - Cycle slots (current: ");
  // Serial.print(netSlot);
  // Serial.print(")\n\r");
  // Serial.print("\ty - Load current slot\n\r");
  // Serial.print("\tf - Read new node connections\n\r");
  // Serial.print("\tr - Toggle rotary encoder mode\n\r");

  // Serial.print("\n\tProbing & Testing:\n\r");
  // Serial.print("\tp - Probe connections\n\r");
  // Serial.print("\tc - Clear nodes with probe\n\r");
  // Serial.print("\tv - Toggle voltage/current display\n\r");
  // Serial.print("\tq/Q - Set GPIO 0 LOW/HIGH\n\r");

  // Serial.print("\n\tConfiguration:\n\r"); 
  // Serial.print("\ta/A - Disconnect/Connect UART to Nano\n\r");
  // Serial.print("\tl - LED brightness/test\n\r");
  // Serial.print("\tu - Set USB-Serial baud rate\n\r");
  // Serial.print("\td - Debug flags\n\r");

  // Serial.print("\n\tAdvanced:\n\r");
  // Serial.print("\tb - Show bridge array & paths\n\r");
  // Serial.print("\ts - Show node files by slot\n\r");
  // Serial.print("\to - Load node files by slot\n\r");
  // Serial.print("\th - Send raw XY paths\n\r");
  // Serial.print("\tw - Wave generator\n\r");
  // Serial.print("\tj - Read probe row\n\r");

  // Serial.print("\n\tSystem:\n\r");
  // Serial.print("\t? - Show firmware version\n\r");
  // Serial.print("\t$ - Show current slot number\n\r");
  // Serial.print("\t: - Enter machine mode\n\r");
  // Serial.print("\n\r");





  if (firstLoop == 1 && rotaryEncoderMode == 1) {
    Serial.print("Use the rotary encoder to change slots\n\r");
    Serial.print("Press the button to select\n\r");
    Serial.print("\n\n\r");
    firstLoop = 0;
    probeActive = 0;

    goto loadfile;
    } else if (firstLoop == 1) {
      // delay(20);
      // Serial.println("Press the button to load the current slot\n\r");
      // delay(20);
      firstLoop = 0;
      probeActive = 0;

      goto loadfile;
      }
    // if (firstLoop == 1 && rotaryEncoderMode == 0 && loadFileOnStart == 1)
    // {
    //   delay(50);
    //   firstLoop = 0;
    //   probeActive = 0;

    //   goto loadfile;
    // }

    // Serial.print("Slot: ");
    // Serial.println(netSlot);

  dontshowmenu:

    connectFromArduino = '\0';
    arduinoCommand = '\0';


    while (Serial.available() == 0 && connectFromArduino == '\0' &&
           slotChanged == 0) {

      pauseCore1 = 1;
      while (pauseCore1 == 1);

      if (readingFromArduino == 1) {
        savePreformattedNodeFile(1, netSlot, rotaryEncoderMode, 1);
        readingFromArduino = 0;
        goto loadfile;
        }
      if (readingFromArduino == 2) {
        savePreformattedNodeFile(1, netSlot, rotaryEncoderMode, 0);
        readingFromArduino = 0;
        goto loadfile;
        }
      if (showReadings >= 1) {
        showMeasurements();
        // Serial.print("\n\n\r");
        // showLEDsCore2 = 1;
        }
      // if (BOOTSEL) {
      //   //lastNetConfirm(1);
      // }
      int dontCheckButton = 0;


      if (dontCheckButton == 0) {

        if (millis() - lastButtonCheck > buttonCheckInterval) {
          lastButtonCheck = millis();

          if (checkProbeButton() == 1) {
            int longShort = longShortPress(1000);
            if (longShort == 1) {
              input = 'c';
              probingTimer = millis();
              goto skipinput;
              } else if (longShort == 0) {
                input = 'p';
                probingTimer = millis();
                goto skipinput;
                }
            }


          // pinMode(19, INPUT);
          }
        }

      if (arduinoCommand != '\0') {
        input = arduinoCommand;
        Serial.println("arduinoCommand");
        //arduinoCommand = '\0';
        goto skipinput;
        }

      if (readingFromArduino == 3) {
        input = 'j';
        goto skipinput;
        }

      }

    if (slotChanged == 1) {

      // showLEDsCore2 = 1;

      goto loadfile;
      }

    if (connectFromArduino != '\0') {


      } else {
      input = Serial.read();
      // Serial.print("\n\r");
      if (input == '}' || input == ' ' || input == '\n' || input == '\r') {
        goto dontshowmenu;
        }
      // Serial.write(input);
      }


  skipinput:
    Serial.println(input);
    while (pauseCore1 == 1);


    switch (input) {
      case 'j': {

      int readProbe = justReadProbe();

      if (readingFromArduino > 0) {

        printNodeOrName(readProbe, 0, 1);
        Serial.println(readProbe);
        Serial.println();


        } else {
        printNodeOrName(readProbe, 0, 0);
        Serial.println();
        }

      readingFromArduino = 0;
      break;
      }
      case 'A': {
      pauseCore2 = 1;
      removeBridgeFromNodeFile(NANO_D1, -1, netSlot);
      removeBridgeFromNodeFile(NANO_D0, -1, netSlot);
      addBridgeToNodeFile(RP_UART_RX, NANO_D1, netSlot);
      addBridgeToNodeFile(RP_UART_TX, NANO_D0, netSlot);
      //loadFile(netSlot);
      pauseCore2 = 0;
      input = ' ';
      goto loadfile;
      break;
      }
      case 'a': {
      //pauseCore2 = 1;
      // abortWait = 1;
      // while (abortWait == 1);

  // addBridgeToNodeFile(RP_UART_RX, NANO_D1);
  // addBridgeToNodeFile(RP_UART_TX, NANO_D0);
      removeBridgeFromNodeFile(NANO_D1, -1, netSlot);
      removeBridgeFromNodeFile(NANO_D0, -1, netSlot);
      //pauseCore2 = 0;
      //loadFile(netSlot);
      input = ' ';
      goto loadfile;
      break;
      }
      case 'H': {
      if (parseRaw(1) == 1) {
        sendXYraw(rawConn[1], rawConn[2], rawConn[3], 1);
        }
      break;
      }
      case 'h': {

      if (parseRaw(0) == 1) {
        sendXYraw(rawConn[1], rawConn[2], rawConn[3], 0);
        }

      break;
      }
      case '?': {
      Serial.print("Jumperless firmware version: ");
      Serial.println(firmwareVersion);
      break;
      }
      case '$': {
      // return current slot number
      Serial.println(netSlot);
      break;
      }
      case '_': // hold arduino in reset
      {
      pinMode(16, OUTPUT);
      pinMode(17, INPUT);
      clearAllConnectionsOnChip(CHIP_I, 0);

      sendXYraw(CHIP_I, 11, 0, 1);
      sendXYraw(CHIP_I, 15, 0, 1);

      sendXYraw(CHIP_I, 11, 1, 1); // double up connections
      sendXYraw(CHIP_I, 15, 1, 1);

      goto dontshowmenu;
      }
      case '-': {
      clearAllConnectionsOnChip(CHIP_I, 1);

      sendXYraw(CHIP_I, 11, 0, 0);
      sendXYraw(CHIP_I, 15, 0, 0);

      sendXYraw(CHIP_I, 11, 1, 0); // double up connections
      sendXYraw(CHIP_I, 15, 1, 0);

      sendAllPathsCore2 = 1;

      break;
      }
      case 'e': {
      if (showExtraMenu == 0) {
        showExtraMenu = 1;
        } else {
        showExtraMenu = 0;
        }
      break;
      }

      case 's': {
      int fileNo = -1;

      if (Serial.available() > 0) {
        fileNo = Serial.read();
        // break;
        }
      Serial.print("\n\n\r");
      if (fileNo == -1) {
        Serial.print("\tSlot Files");
        } else {
        Serial.print("\tSlot File ");
        Serial.print(fileNo - '0');
        }
      Serial.print("\n\n\r");
      Serial.print(
          "\n\ryou can paste this text reload this circuit (enter 'o' first)");
      Serial.print("\n\r(or even just a single slot)\n\n\n\r");
      if (fileNo == -1) {
        for (int i = 0; i < NUM_SLOTS; i++) {
          Serial.print("\n\rSlot ");
          Serial.print(i);
          if (i == netSlot) {
            Serial.print("        <--- current slot");
            }

          Serial.print("\n\rnodeFileSlot");
          Serial.print(i);
          Serial.print(".txt\n\r");

          Serial.print("\n\rf ");
          printNodeFile(i);
          Serial.print("\n\n\n\r");
          }
        } else {

        Serial.print("\n\rnodeFileSlot");
        Serial.print(fileNo - '0');
        Serial.print(".txt\n\r");

        Serial.print("\n\rf ");

        printNodeFile(fileNo - '0');
        Serial.print("\n\r");
        }

      break;
      }
      case 'v':

        if (showReadings >= 3 || (inaConnected == 0 && showReadings >= 1)) {
          showReadings = 0;
          break;
          } else {
          showReadings++;

          chooseShownReadings();
          // Serial.println(showReadings);

          // Serial.write("\033"); //these VT100/ANSI commands work on some
          // terminals and not others so I took it out Serial.write("\x1B\x5B");
          // Serial.write("1F");//scroll up one line
          // Serial.write("\x1B\x5B");
          // Serial.write("\033");
          // Serial.write("2K");//clear line
          // Serial.write("\033");
          // Serial.write("\x1B\x5B");
          // Serial.write("1F");//scroll up one line
          // Serial.write("\x1B\x5B");
          // Serial.write("\033");
          // Serial.write("2K");//clear line

          goto dontshowmenu;
          // break;
          }
      case 'p': {
      probeActive = 1;

      delayMicroseconds(1500);
      probeMode(19, 1);
      delayMicroseconds(1500);
      probeActive = 0;
      break;
      }
      case 'c': {
      // removeBridgeFromNodeFile(19, 1);
      probeActive = 1;
      delayMicroseconds(1500);
      probeMode(19, 0);
      delayMicroseconds(1500);
      probeActive = 0;
      break;
      }
      case 'n':
        couldntFindPath(1);
        Serial.print("\n\n\rnetlist\n\n\r");
        listSpecialNets();
        listNets();

        break;
      case 'b':
        couldntFindPath(1);
        Serial.print("\n\n\rBridge Array\n\r");
        printBridgeArray();
        Serial.print("\n\n\n\rPaths\n\r");
        printPathsCompact();
        Serial.print("\n\n\rChip Status\n\r");
        printChipStatus();
        Serial.print("\n\n\r");
        Serial.print("Revision ");
        Serial.print(revisionNumber);
        Serial.print("\n\n\r");
        break;

      case 'm':

        break;

      case '!':
        printNodeFile();
        break;

      case '*': {
      excelCounter++;
      Serial.print("42, 56.9, ");
      Serial.println(excelCounter);
      break;
      }

      case 'w':

        if (waveGen() == 1) {
          break;
          }
      case 'o': {
      probeActive = 1;
      inputNodeFileList(rotaryEncoderMode);
      showSavedColors(netSlot);
      // input = ' ';
      showLEDsCore2 = 1;
      sendAllPathsCore2 = 1;
      probeActive = 0;
      chooseShownReadings();
      goto dontshowmenu;
      break;
      }
      case '&': {
      int numberOfAddressBits = 0;
      int addressRows[20] = { -1 };

      // while (Serial.available() > 0) {
      //   Serial.read();
      // }

      Serial.print("\n\rEnter rows for address lines (lsb first)\n\r(enter x "
                   "when finished)\n\r");
      for (int i = 0; i < 20; i++) {

        Serial.print("\n\rAddress ");
        Serial.print(i);
        Serial.print(">  ");

        while (Serial.available() == 0) {
          }

        int row = Serial.read();
        if (row == 'x') {
          numberOfAddressBits = i;
          Serial.print("x\n\r");
          break;
          }
        if (isDigit(row) == false) {
          continue;
          }

        addressRows[i] = row - '0';
        char nextChar = Serial.peek();
        if (Serial.available() > 0 && isDigit(nextChar) == true) {
          row = Serial.read();

          addressRows[i] *= 10;
          addressRows[i] += row - '0';
          }

        // Serial.print(addressRows[i]);
        }

      for (int i = 0; i < numberOfAddressBits; i++) {
        Serial.print(addressRows[i]);
        Serial.print(" ");
        }

      int numberOfDataBits = 0;
      int dataRows[20] = { -1 };

      // while (Serial.available() > 0) {
      //   Serial.read();
      // }

      Serial.print("\n\rEnter rows for data lines (lsb first)\n\r(enter x when "
                   "finished)\n\r");
      for (int i = 0; i < 20; i++) {

        Serial.print("\n\rData ");
        Serial.print(i);
        Serial.print(">  ");

        while (Serial.available() <= 0) {
          }

        int row = Serial.read();
        if (row == 'x') {
          numberOfDataBits = i;
          Serial.print("x\n\r");
          break;
          }
        if (isDigit(row) == false) {
          continue;
          }

        dataRows[i] = row - '0';
        char nextChar = Serial.peek();
        if (Serial.available() > 0 && isDigit(nextChar) == true) {
          row = Serial.read();

          dataRows[i] *= 10;
          dataRows[i] += row - '0';
          }

        Serial.print(dataRows[i]);
        }

      int clockRow = 0;

      // while (Serial.available() > 0) {
      //   Serial.read();
      // }

      Serial.print("enter clock row\n\rClock >");

      while (Serial.available() == 0) {
        }

      int row = Serial.read();
      if (isDigit(row) == false) {

        } else {

        clockRow = row - '0';
        if (Serial.available() > 0 && Serial.peek() != '\n') {
          row = Serial.read();

          clockRow *= 10;
          clockRow += row - '0';
          }
        }
      Serial.print("\n\n\n\n\r");

      Serial.print("\n\rNumber of address bits: ");
      Serial.print(numberOfAddressBits);
      // Serial.print("\n\r");
      Serial.print("\n\rNumber of data bits: ");
      Serial.print(numberOfDataBits);
      Serial.print("\n\r");
      Serial.print("\n\rClock row: ");

      Serial.print(clockRow);
      Serial.print("\n\r");
      for (int i = 0; i < numberOfAddressBits; i++) {
        Serial.print("a");
        Serial.print(i);
        Serial.print(": ");
        Serial.print(addressRows[i]);
        Serial.print("  ");
        }

      Serial.print("\n\r");
      for (int i = 0; i < numberOfDataBits; i++) {
        Serial.print("d");
        Serial.print(i);
        Serial.print(": ");
        Serial.print(dataRows[i]);
        Serial.print("  ");
        }

      // createSlots(netSlot, 0); //clears the netlist
      int addressCount = 0;

      bool addressBits[20] = { 0 };

      bool dataBits[20] = { 0 };

      for (addressCount = 0; addressCount < pow(2, numberOfAddressBits);
           addressCount++) {
        addressBits[addressRows[addressCount]] = 1;
        // Serial.println(addressRows[addressCount], BIN);
        // Serial.println(addressCount, BIN);

        // createSlots(netSlot, 0); // clears the netlist
        // delay(100);

        for (int i = 0; i < numberOfAddressBits; i++) {
          // Serial.print(addressCount & (1 << i) ? "1" : "0");
          addressBits[i] = addressCount & (1 << i);

          Serial.print(addressBits[i] == true ? "1" : "0");
          removeBridgeFromNodeFile(addressRows[i], -1, netSlot);
          delay(1);
          addBridgeToNodeFile(addressRows[i],
                              addressBits[i] == true ? SUPPLY_5V : GND, netSlot);
          }
        Serial.println();
        // TODO: add data bits or do something with them
        // TODO: wiggle the clock line

        delay(10);
        // printNodeFile();

        probeActive = 1;
        clearAllNTCC();
        openNodeFile(netSlot);
        getNodesToConnect();
        bridgesToPaths();
        clearLEDs();
        digitalWrite(RESETPIN, HIGH);
        delayMicroseconds(100);
        digitalWrite(RESETPIN, LOW);
        showSavedColors(netSlot);
        chooseShownReadings();
        sendAllPathsCore2 = 1;
        showLEDsCore2 = 1;
        probeActive = 0;

        delay(200);
        }

      break;
      }

      case 'x': {

      if (netSlot == NUM_SLOTS - 1) {
        netSlot = 0;
        } else {
        netSlot++;
        }

      Serial.print("\r                                         \r");
      Serial.print("Slot ");
      Serial.print(netSlot);
      slotPreview = netSlot;
      chooseShownReadings();
      goto loadfile;
      }
      case 'z': {

      if (netSlot == 0) {
        netSlot = NUM_SLOTS - 1;
        } else {
        netSlot--;
        }
      Serial.print("\r                                         \r");
      Serial.print("Slot ");
      Serial.print(netSlot);
      slotPreview = netSlot;
      chooseShownReadings();
      goto loadfile;
      }
      case 'y': {
    loadfile:
      pauseCore2 = 1;
      probeActive = 1;
      clearAllNTCC();
      openNodeFile(netSlot);
      getNodesToConnect();
      bridgesToPaths();
      clearLEDs();
      // leds.clear();
      // assignNetColors();
      digitalWrite(RESETPIN, HIGH);
      delayMicroseconds(3900);
      // Serial.print("bridgesToPaths\n\r");
      digitalWrite(RESETPIN, LOW);
      // showNets();
      // saveRawColors(netSlot);
      probeActive = 0;
      showSavedColors(netSlot);
      chooseShownReadings();
      pauseCore2 = 0;
      sendAllPathsCore2 = 1;
      slotChanged = 0;
      input = ' ';
      // break;
      // if (rotaryEncoderMode == 1)
      // {
      //   goto dontshowmenu;
      // }

      break;
      }
      case 'q': {
      digitalWrite(0, LOW);
      break;
      }
      case 'Q': {
      digitalWrite(0, HIGH);
      break;
      }
      case 'f':

        probeActive = 1;
        readInNodesArduino = 1;
        clearAllNTCC();

        // sendAllPathsCore2 = 1;
        timer = millis();

        // clearNodeFile(netSlot);
        //digitalWrite(RESETPIN, HIGH);
        if (connectFromArduino != '\0') {
          serSource = 1;
          } else {
          serSource = 0;
          }
        savePreformattedNodeFile(serSource, netSlot, rotaryEncoderMode);

        // Serial.print("savePFNF\n\r");
        // debugFP = 1;
        openNodeFile(netSlot);
        getNodesToConnect();
        // Serial.print("openNF\n\r");

        bridgesToPaths();
        clearLEDs();
        assignNetColors();
        //delay(10);
        // Serial.print("bridgesToPaths\n\r");
        //digitalWrite(RESETPIN, LOW);
        // showNets();
        // saveRawColors(netSlot);
        chooseShownReadings();
        sendAllPathsCore2 = 1;
        showLEDsCore2 = 1;

        if (debugNMtime) {
          Serial.print("\n\n\r");
          Serial.print("took ");
          Serial.print(millis() - timer);
          Serial.print("ms");
          }
        //input = ' ';

        probeActive = 0;
        if (connectFromArduino != '\0') {
          connectFromArduino = '\0';
          // Serial.print("connectFromArduino\n\r");
          //  delay(2000);
          //input = ' ';


          goto dontshowmenu;
          }

        connectFromArduino = '\0';
        readInNodesArduino = 0;
        break;

      case '\n':
        goto menu;
        break;

      case 't':
#ifdef FSSTUFF
        clearNodeFile();
#endif

#ifdef EEPROMSTUFF
        lastCommandWrite(input);

        runCommandAfterReset('t');
#endif

#ifdef FSSTUFF
        openNodeFile();
        getNodesToConnect();
#endif
        Serial.println("\n\n\rnetlist\n\n\r");

        bridgesToPaths();

        listSpecialNets();
        listNets();
        printBridgeArray();
        Serial.print("\n\n\r");
        Serial.print(numberOfNets);

        Serial.print("\n\n\r");
        Serial.print(numberOfPaths);

        assignNetColors();
#ifdef PIOSTUFF
        sendAllPaths();
#endif

        break;

      case 'l':
        if (LEDbrightnessMenu() == '!') {
          clearLEDs();
          delayMicroseconds(9200);
          sendAllPathsCore2 = 1;
          }
        break;

      case 'r':
        if (rotaryEncoderInitialized == 0) {
          initRotaryEncoder();
          rotaryEncoderInitialized = 1;
          }
        if (rotaryEncoderMode == 1) {
          // unInitRotaryEncoder();

          rotaryEncoderMode = 0;
          // createSlots(-1, rotaryEncoderMode);
          //  showSavedColors(netSlot);
          // assignNetColors();

          // showNets();
          lightUpRail();

          showLEDsCore2 = 1;
          debugFlagSet(10); // encoderModeOff
          goto menu;
          } else {
          rotaryEncoderMode = 1;
          if (rotEncInit == 0) // only do this once
            {
            createSlots(-1, rotaryEncoderMode);
            // initRotaryEncoder();
            rotEncInit = 1;
            // Serial.print("\n\n\r (you should unplug an)");
            }
          printRotaryEncoderHelp();
          delay(100);
          // initRotaryEncoder();
          // refreshSavedColors();
          showSavedColors(netSlot);
          showLEDsCore2 = 1;
          debugFlagSet(11); // encoderModeOn

          //   delay(700);
          //   Serial.flush();
          //   Serial.end();

          //   delay(700);
          //       watchdog_enable(1, 1);
          // while(1);
          //*((volatile uint32_t*)(PPB_BASE + 0x0ED0C)) = 0x5FA0004;
          }
        goto dontshowmenu;

        break;

      case 'u':
        Serial.print("\n\r");
        Serial.print("enter baud rate\n\r");
        while (Serial.available() == 0)
          ;
        baudRate = Serial.parseInt();
        Serial.print("\n\r");
        Serial.print("setting baud rate to ");
        Serial.print(baudRate);
        Serial.print("\n\r");

        setBaudRate(baudRate);
        break;

      case 'd': {
      debugFlagInit();

    debugFlags:

      Serial.print("\n\r0.   all off");
      Serial.print("\n\r9.   all on");
      Serial.print("\n\ra-z. exit\n\r");

      Serial.print("\n\r1. file parsing           =    ");
      Serial.print(debugFP);
      Serial.print("\n\r2. net manager            =    ");
      Serial.print(debugNM);
      Serial.print("\n\r3. chip connections       =    ");
      Serial.print(debugNTCC);
      Serial.print("\n\r4. chip conns alt paths   =    ");
      Serial.print(debugNTCC2);
      Serial.print("\n\r5. LEDs                   =    ");
      Serial.print(debugLEDs);
      Serial.print("\n\n\r6. swap probe pin         =    ");
      if (probeSwap == 0) {
        Serial.print("19");
        } else {
        Serial.print("18");
        }
      Serial.print("\n\n\r7. load slots on start    =    ");
      Serial.print(loadFileOnStart ? "on" : "off");

      Serial.print("\n\n\n\r");

      while (Serial.available() == 0)
        ;

      int toggleDebug = Serial.read();
      Serial.write(toggleDebug);
      toggleDebug -= '0';

      if (toggleDebug >= 0 && toggleDebug <= 9) {

        debugFlagSet(toggleDebug);

        delay(10);

        goto debugFlags;
        } else {
        break;
        }
      }

      case ':':

        if (Serial.read() == ':') {
          // Serial.print("\n\r");
          // Serial.print("entering machine mode\n\r");
          machineMode();
          showLEDsCore2 = 1;
          goto dontshowmenu;
          break;
          } else {
          break;
          }

      default:
        while (Serial.available() > 0) {
          int f = Serial.read();
          delayMicroseconds(30);
          }

        break;
      }
    arduinoCommand = '\0';
    goto menu;


  }

// #include <string> // Include the necessary header file


void loadFile(int slot) {
  //pauseCore1 = 1;
  clearAllNTCC();
  openNodeFile(netSlot);
  getNodesToConnect();
  bridgesToPaths();
  clearLEDs();
  assignNetColors();
  digitalWrite(RESETPIN, HIGH);
  delayMicroseconds(2000);
  // Serial.print("bridgesToPaths\n\r");
  digitalWrite(RESETPIN, LOW);
  // showNets();
  //saveRawColors(netSlot);
  //pauseCore1 = 0;
  sendAllPathsCore2 = 1;
  showLEDsCore2 = 1;
  /// input = ' ';
  }

unsigned long logoFlashTimer = 0;


unsigned long lastTimeReset = 0;
volatile uint8_t pauseCore2 = 0;

const char commandPassthrough = '\x01';
const char commandJumperlessOnly = '\x02';
const char commandFinished = '\x04';
// char commandConnectPassthrough = 0x13;
// char commandConnectJumperlessOnly = 0x14;

int lastUARTcommand = 0;


void loop1() // core 2 handles the LEDs and the CH446Q8
  {

  // while (1) rainbowBounce(50); //I uncomment this to test the LEDs on a fresh
  // board

  while (pauseCore2 == 1) {
    }

  if (showLEDsCore2 >= 1) {
    int rails = showLEDsCore2;

    if (rails == 1 || rails == 2) {
      lightUpRail(-1, -1, 1, 28, supplySwitchPosition);
      }
    Serial.print("rails: ");
    Serial.println(rails);

    Serial.print("rails: ");
    Serial.println(rails);

    Serial.print("rails: ");
    Serial.println(rails);
    Serial.print("fuck");
    Serial.println(rails);

    Serial.print("fuck");
    Serial.println(rails);



    Serial.print("rails: ");
    Serial.println(rails);
    Serial.print("fuck");
    Serial.println(rails);

    Serial.print("rails: ");
    Serial.println(rails);
    Serial.print("fuck");
    Serial.println(rails);

    Serial.print("rails: ");
    Serial.println(rails);
    Serial.print("fuck");
    Serial.println(rails);

    Serial.print("rails: ");
    Serial.println(rails);
    Serial.print("fuck");
    Serial.println(rails);




    if (rails != 2) {
      showNets();
      }

    if (rails > 3) {
      Serial.print("\n\r");
      Serial.print(rails);
      }
    delayMicroseconds(2200);

    leds.show();
    delayMicroseconds(5200);
    showLEDsCore2 = 0;
    }

  if (sendAllPathsCore2 == 1) {
    digitalWrite(RESETPIN, HIGH);
    delayMicroseconds(4900);
    digitalWrite(RESETPIN, LOW);
    delayMicroseconds(4200);
    sendAllPaths();
    delayMicroseconds(2200);
    showNets();
    delayMicroseconds(7200);
    sendAllPathsCore2 = 0;
    }

  if (arduinoReset == 0 &&
      USBSer1.peek() == 0x30) // 0x30 is the first thing AVRDUDE sends
    {

    resetArduino();
    arduinoReset = 1;
    lastTimeReset = millis();
    pauseCore1 = 1;
    }


  while (arduinoReset == 1) {


    if (USBSer1.available()) {

      char ch = USBSer1.read();
      // Serial.write(ch);
      Serial1.write(ch);
      }

    if (Serial1.available()) {
      char ch = Serial1.read();
      // Serial.write(ch);
      USBSer1.write(ch);
      }

    if (millis() - lastTimeReset >
        4000) // if the arduino hasn't been reset in a second, reset the flag
      {
      arduinoReset = 0;
      pauseCore1 = 0;
      }
    }

  if (readInNodesArduino == 0) {

    while (USBSer1.available()) {

      char chs = USBSer1.read();
      Serial1.write(chs);
      //Serial.print(chs);
      }




    if (Serial1.available()) {


      char chs = Serial1.peek();
      //Serial.println("chs");
      // Serial.println(chs);
      //lastUARTcommand = 0;
      if (chs == commandPassthrough) {
        lastUARTcommand = 1;
        char trash = Serial1.read();
        //input = Serial1.read();
        //Serial.println("input passthrough");
        //delay(1000);
        chs = Serial1.read();

        if (chs != 'f' && chs != 'j') {
          //input = chs;
          //arduinoCommand = chs;

          // while (arduinoCommand != '\0') {
          //   //delayMicroseconds(200);
          //   }
          //Serial.println("input");

          }

        } else if (chs == commandJumperlessOnly) {
          lastUARTcommand = 2;
          //Serial.println("input");
          char trash = Serial1.read();
          //input = Serial1.read();
          chs = Serial1.read();

          if (chs != 'f' && chs != 'j') {
            //input = chs;
            //arduinoCommand = chs;
            //Serial.println("input");
            // while (arduinoCommand != '\0') {
            //  // delayMicroseconds(200);
            //   }

            }
          //  USBSer1.write(chs);

          } else if (chs == commandFinished) {
            lastUARTcommand = 0;
            char trash = Serial1.read();
            //input = Serial1.read();
            chs = Serial1.read();
            //USBSer1.write(chs);



            }




          if (lastUARTcommand > 0) {

            if (lastUARTcommand != 2) {
              USBSer1.write(chs);
              }

            if (chs == '\x02' && pauseCore2 == 0) {
              // Serial.println("2");
              readingFromArduino = 1;

              while (readingFromArduino == 1) {
                delayMicroseconds(200);
                }

              } else if (chs == 'f') {

                readingFromArduino = 2;
                //savePreformattedNodeFile(1, netSlot, rotaryEncoderMode, 1);
                //Serial.println("2");

                while (readingFromArduino == 2) {
                  delayMicroseconds(200);
                  }
                } else if (chs == 'j') {

                  char trash = Serial1.read();
                  input = 'j';
                  readingFromArduino = 3;
                  } else {
                  char trash = Serial1.read();

                  //arduinoCommand = chs;

                  // while (arduinoCommand != '\0') {
                  //   //delayMicroseconds(200);
                  //   }


                  //input = chs;
                  }


            } else {
            char trash = Serial1.read();
            if (lastUARTcommand == 0) {
              USBSer1.write(chs);
              }
            }


          //
      } else if (serial1messageReady == 1) {
        Serial1.print(serial1message);
        Serial.print(serial1message);
        for (int i = 0; i < 300; i++) {
          serial1message[i] = '\0';
          }
        serial1messageReady = 0;
        }
    }




  if (rotaryEncoderMode == 1) {
    rotaryEncoderStuff();
    } else {
    showingPreview = 0;

    if (logoFlash == 2) {
      logoFlashTimer = millis();
      logoFlash = 1;
      }

    if (logoFlash == 1 && logoFlashTimer != 0 &&
        millis() - logoFlashTimer > (20)) {
      logoFlash = 0;
      logoFlashTimer = 0;
      lightUpRail();
      //  if (rotaryEncoderMode == 1)
      //  {
      //    showSavedColors(netSlot);
      //  }
      leds.setPixelColor(110, rawOtherColors[1]);
      // showLEDsCore2 = 1;
      leds.show();
      }
    }
  if (showReadings == 0 && probeActive == 0) {
    showLEDmeasurements();
    }

  // logicAnalyzer.processCommand();
  }
