joelsa/Jumperless/JumperlessBackport/src/JumperlessDefinesRP2040.h

// SPDX-License-Identifier: MIT

#ifndef JUMPERLESSDEFINESRP2040_H
#define JUMPERLESSDEFINESRP2040_H



extern volatile int sendAllPathsCore2;
extern volatile int showLEDsCore2;
extern volatile int core1busy;
extern volatile int core2busy;
extern volatile int core1request;



#define INPUTBUFFERLENGTH 8000


#define PIOSTUFF 1 //comment these out to remove them
#define EEPROMSTUFF 1
#define FSSTUFF 1


#define QUADRATURE_A_PIN 16
#define QUADRATURE_B_PIN 17
#define BUTTON_ENC 0


#define LOADFILEONSTART_ADDRESS 29
#define ROTARYENCODER_MODE_ADDRESS 31
#define DEBUG_FILEPARSINGADDRESS 32
#define TIME_FILEPARSINGADDRESS 33
#define DEBUG_NETMANAGERADDRESS 34
#define TIME_NETMANAGERADDRESS 35
#define DEBUG_LEDSADDRESS 36
#define DEBUG_NETTOCHIPCONNECTIONSADDRESS 37
#define DEBUG_NETTOCHIPCONNECTIONSALTADDRESS 38
#define LEDBRIGHTNESSADDRESS 39
#define RAILBRIGHTNESSADDRESS 40
#define SPECIALBRIGHTNESSADDRESS 41
#define PROBESWAPADDRESS 42

#define FIRSTSTARTUPADDRESS 43





#define MAX_NETS 64
#define MAX_BRIDGES 255
#define MAX_NODES 64
#define MAX_DNI 8 //max number of doNotIntersect rules
#define MAX_DUPLICATE 12

#define LASTCOMMANDADDRESS 1
#define CLEARBEFORECOMMANDADDRESS 4

#define AIRCR_Register (*((volatile uint32_t *)(PPB_BASE + 0x0ED0C)))


#define CHIP_A 0
#define CHIP_B 1
#define CHIP_C 2
#define CHIP_D 3
#define CHIP_E 4
#define CHIP_F 5
#define CHIP_G 6
#define CHIP_H 7
#define CHIP_I 8
#define CHIP_J 9
#define CHIP_K 10
#define CHIP_L 11


#define CS_A 6
#define CS_B 7
#define CS_C 8
#define CS_D 9
#define CS_E 10
#define CS_F 11
#define CS_G 12
#define CS_H 13

#define CS_I 20
#define CS_J 21
#define CS_K 22
#define CS_L 23

//#define DATAPIN 14
#define RESETPIN 24
//#define CLKPIN 15

#define UART0_TX 0
#define UART0_RX 1

#define NANO_I2C1_SCL 2 //These might be flipped on the RP2040, fuck
#define NANO_I2C1_SDA 3

#define I2C0_SDA 4
#define I2C0_SCL 5 

#define LED_DATA_OUT 6

#define ADC0_PIN 26
#define ADC1_PIN 27
#define ADC2_PIN 28
#define ADC3_PIN 29

#define T_RAIL_POS 31
#define T_RAIL_NEG 0
#define B_RAIL_POS 63
#define B_RAIL_NEG 32


#define TOP_1  1
#define TOP_2  2
#define TOP_3  3
#define TOP_4  4
#define TOP_5  5
#define TOP_6  6
#define TOP_7  7
#define TOP_8  8
#define TOP_9  9
#define TOP_10 10
#define TOP_11 11
#define TOP_12 12
#define TOP_13 13
#define TOP_14 14
#define TOP_15 15
#define TOP_16 16
#define TOP_17 17
#define TOP_18 18
#define TOP_19 19
#define TOP_20 20
#define TOP_21 21
#define TOP_22 22
#define TOP_23 23
#define TOP_24 24
#define TOP_25 25
#define TOP_26 26
#define TOP_27 27
#define TOP_28 28
#define TOP_29 29
#define TOP_30 30


#define BOTTOM_1 31
#define BOTTOM_2 32
#define BOTTOM_3 33
#define BOTTOM_4 34
#define BOTTOM_5 35
#define BOTTOM_6 36
#define BOTTOM_7 37
#define BOTTOM_8 38
#define BOTTOM_9 39
#define BOTTOM_10 40
#define BOTTOM_11 41
#define BOTTOM_12 42
#define BOTTOM_13 43
#define BOTTOM_14 44
#define BOTTOM_15 45
#define BOTTOM_16 46
#define BOTTOM_17 47
#define BOTTOM_18 48
#define BOTTOM_19 49
#define BOTTOM_20 50
#define BOTTOM_21 51
#define BOTTOM_22 52
#define BOTTOM_23 53
#define BOTTOM_24 54
#define BOTTOM_25 55
#define BOTTOM_26 56
#define BOTTOM_27 57
#define BOTTOM_28 58
#define BOTTOM_29 59
#define BOTTOM_30 60






#define NANO_D0  70 //these are completely arbitrary but they should come in handy
#define NANO_D1  71 
#define NANO_D2  72 
#define NANO_D3  73 
#define NANO_D4  74 
#define NANO_D5  75 
#define NANO_D6  76 
#define NANO_D7  77 
#define NANO_D8  78 
#define NANO_D9  79 
#define NANO_D10  80 
#define NANO_D11  81 
#define NANO_D12  82 
#define NANO_D13  83 
#define NANO_RESET  84 
#define NANO_AREF  85 
#define NANO_A0  86 
#define NANO_A1  87 
#define NANO_A2  88 
#define NANO_A3  89 
#define NANO_A4  90 
#define NANO_A5  91 
#define NANO_A6  92 
#define NANO_A7  93


#define GND  100 
#define SUPPLY_3V3  103
#define SUPPLY_5V  105

#define DAC0  106 
#define DAC1  107

#define ISENSE_PLUS  108
#define ISENSE_MINUS  109

#define ADC0 110
#define ADC1 111
#define ADC2 112
#define ADC3 113

#define RP_GPIO_0 114

#define RP_UART_TX 116  //also GPIO_16
#define RP_GPIO_16 116  //these are the same as the UART pins

#define RP_UART_RX 117  //also GPIO_17
#define RP_GPIO_17 117  //but if we want to use them as GPIO we should use these names



#define RP_GPIO_18 118  //these aren't actually connected to anything
#define RP_GPIO_19 119  //but we might as well define names for them

#define SUPPLY_8V_P 120   //not actually connected to anything
#define SUPPLY_8V_N 121   //not actually connected to anything



/*

#define GND  100 
#define 3V3  103
#define 5V  105

#define 8V  120

#define DAC0 106 
#define DAC1  107

#define I_P  108
#define I_N  109

#define ADC0 110
#define ADC1 111
#define ADC2 112
#define ADC3 113

#define GPIO_0 114

#define UART_TX 116
#define GPIO_16 116  //these are the same as the UART pins

#define UART_RX 117
#define GPIO_17 117  //but if we want to use them as GPIO we should use these names


#define GPIO_18 118  //these aren't actually connected to anything
#define GPIO_19 119  //but we might as well define names for them





*/

#define EMPTY_NET 127



#endif
