joelsa/Jumperless/JumperlessBackport/Adafruit_TinyUSB_Arduino/src/class/audio/audio_device.c

/*
 * The MIT License (MIT)
 *
 * Copyright (c) 2020 Reinhard Panhuber, Jerzy Kasenberg
 *
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
 * This file is part of the TinyUSB stack.
 */

/*
 * This driver supports at most one out EP, one in EP, one control EP, and one feedback EP and one alternative interface other than zero. Hence, only one input terminal and one output terminal are support, if you need more adjust the driver!
 * It supports multiple TX and RX channels.
 *
 * In case you need more alternate interfaces, you need to define additional defines for this specific alternate interface. Just define them and set them in the set_interface function.
 *
 * There are three data flow structures currently implemented, where at least one SW-FIFO is used to decouple the asynchronous processes MCU vs. host
 *
 * 1. Input data -> SW-FIFO -> MCU USB
 *
 * The most easiest version, available in case the target MCU can handle the software FIFO (SW-FIFO) and if it is implemented in the device driver (if yes then dcd_edpt_xfer_fifo() is available)
 *
 * 2. Input data -> SW-FIFO -> Linear buffer -> MCU USB
 *
 * In case the target MCU can not handle a SW-FIFO, a linear buffer is used. This uses the default function dcd_edpt_xfer(). In this case more memory is required.
 *
 * 3. (Input data 1 | Input data 2 | ... | Input data N) ->  (SW-FIFO 1 | SW-FIFO 2 | ... | SW-FIFO N) -> Linear buffer -> MCU USB
 *
 * This case is used if you have more channels which need to be combined into one stream. Every channel has its own SW-FIFO. All data is encoded into an Linear buffer.
 *
 * The same holds in the RX case.
 *
 * */

#include "tusb_option.h"

#if (CFG_TUD_ENABLED && CFG_TUD_AUDIO)

//--------------------------------------------------------------------+
// INCLUDE
//--------------------------------------------------------------------+
#include "device/usbd.h"
#include "device/usbd_pvt.h"

#include "audio_device.h"

//--------------------------------------------------------------------+
// MACRO CONSTANT TYPEDEF
//--------------------------------------------------------------------+

// Use ring buffer if it's available, some MCUs need extra RAM requirements
#ifndef TUD_AUDIO_PREFER_RING_BUFFER
  #if CFG_TUSB_MCU == OPT_MCU_LPC43XX || CFG_TUSB_MCU == OPT_MCU_LPC18XX || CFG_TUSB_MCU == OPT_MCU_MIMXRT
    #define TUD_AUDIO_PREFER_RING_BUFFER 0
  #else
    #define TUD_AUDIO_PREFER_RING_BUFFER 1
  #endif
#endif
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
